atsmith3/IFE_DISPLAY_2017_18/Software/sprites/385_sprites/win_screen.bmp

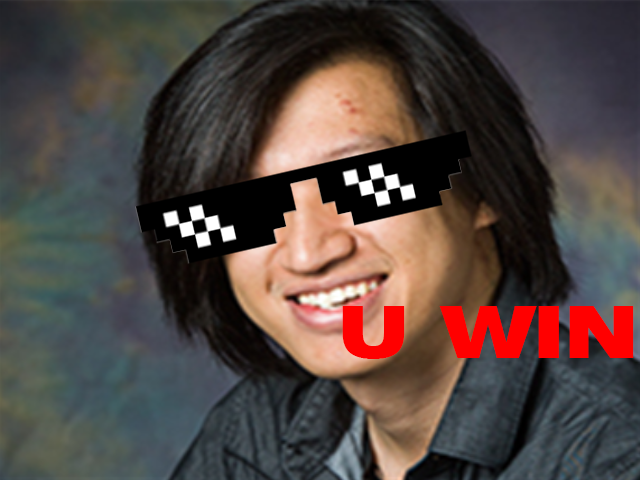
Software/sprites/385_sprites/win_screen.bmp
