atsmith3/IFE_DISPLAY_2017_18/Documentation/BreakoutBoard.JPG

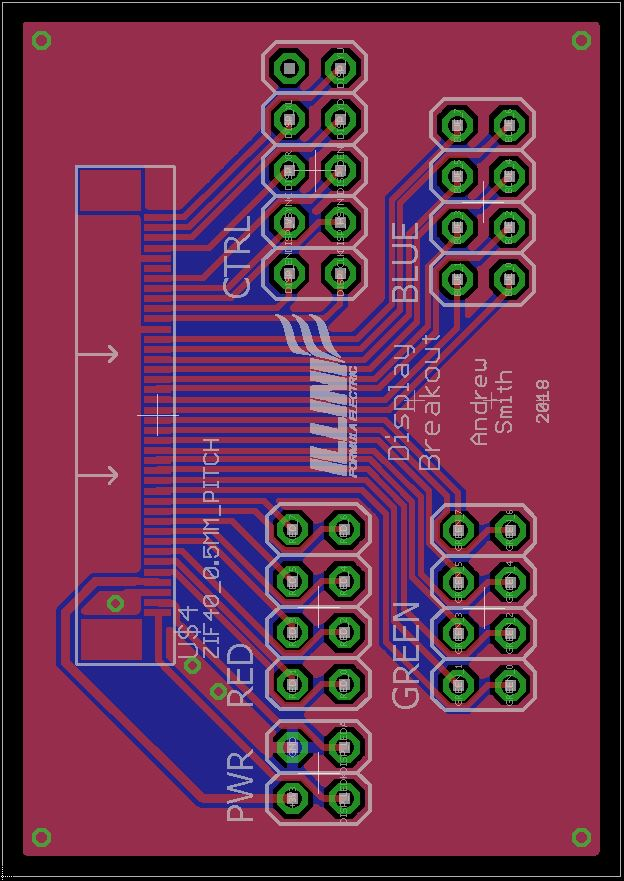
Documentation/BreakoutBoard.JPG
