atsmith3/IFE_DISPLAY_2017_18/Documentation/ife18_lowvoltage_display.pptx

## Display Driver Board

- Low Voltage

- Andrew Smith

## OVERVIEW

- This board will drive a 5.0 inch backlit TFT display to display useful information to the driver.
- Uses a FPGA to dive the display and a microcontroller to interface with the can network and control the sprites on screen.

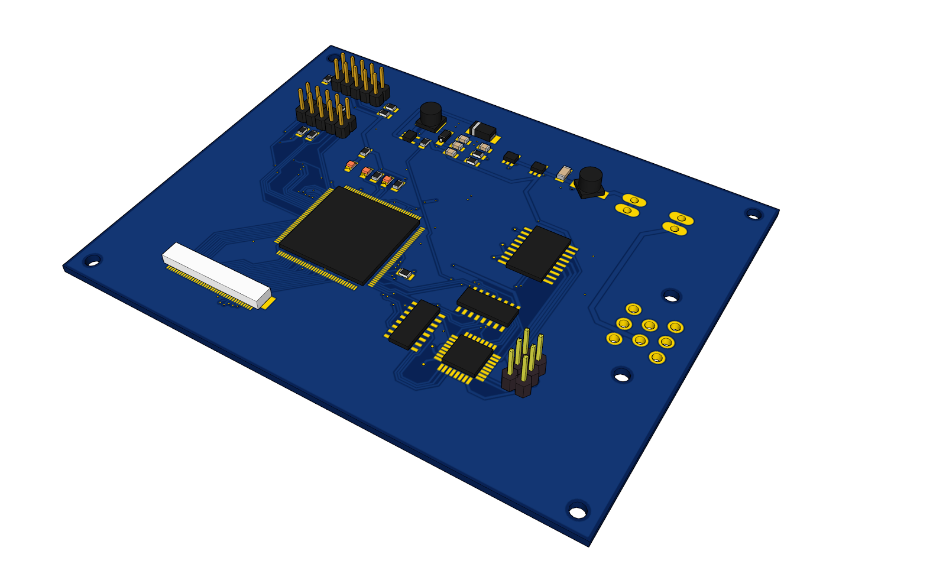
[picture p13: figure]

## Slide 3

- Final Design

## Power Supply

- Linear voltage regulators generate the 5V, 3.3V and 1.2V power levels.
- The FPGA also requires 1.2V supply for its logic elements which will be achieved with a 3.3V to 1.2V voltage regulator.
- Input filter to filter EMI from motor.

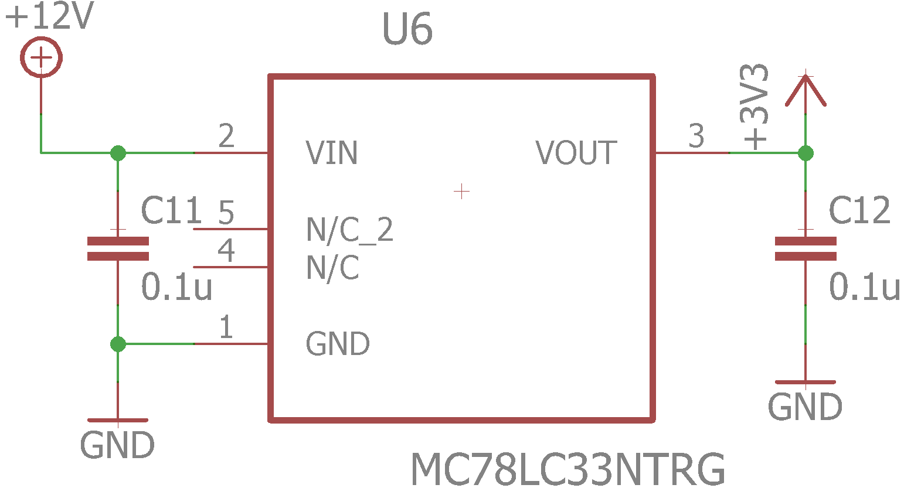
[picture p14: figure]
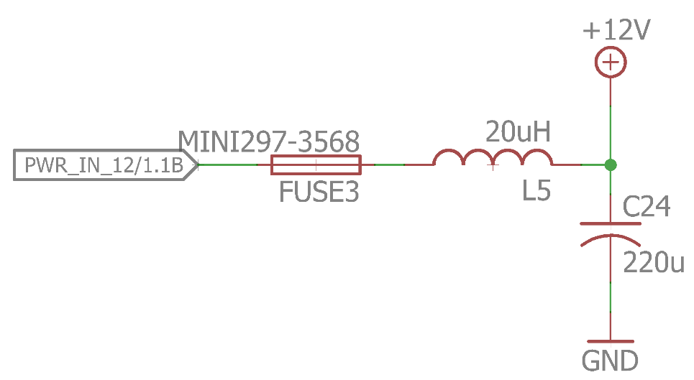
[picture p15: figure]

## Backlight

- Used a simple boost converter chip to boost the 5V supply to 24V to drive the LED backlight on the display.

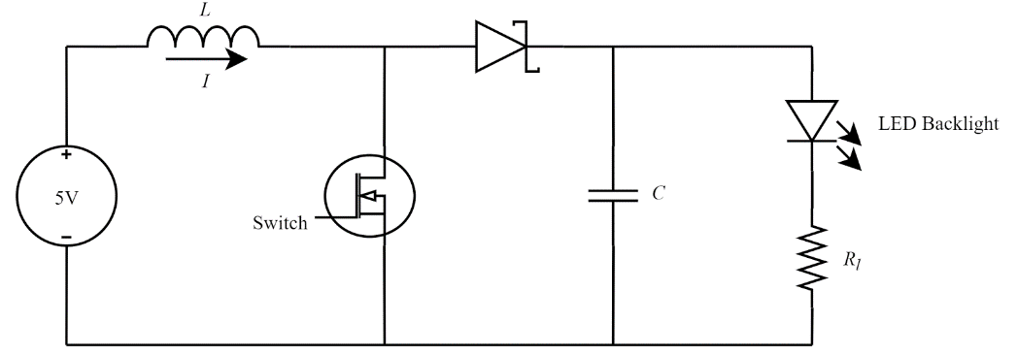
[picture p16: figure]
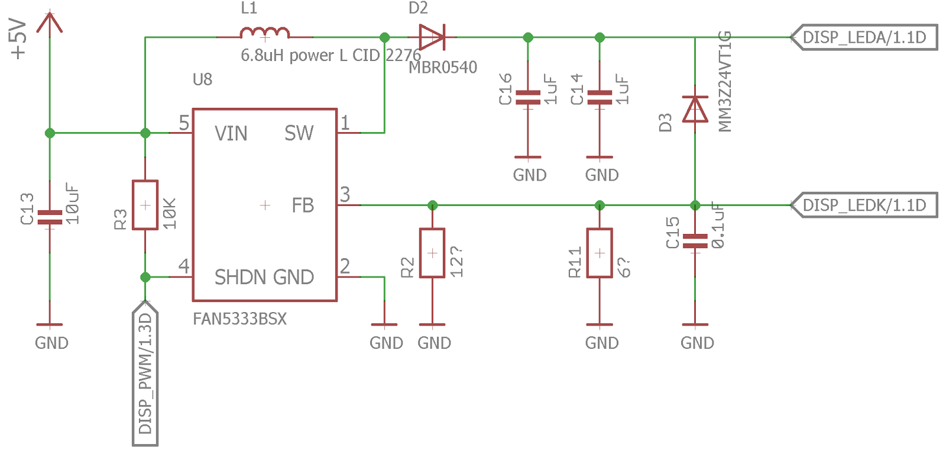
[picture p17: figure]

## FPGA

- I chose an FPGA to write to the display because I figured it would be easier to support custom graphics and be able to switch between different UI designs on the fly.
- The FPGA is a basic Cyclone II from Altera and it will boot off of a configuration flash.

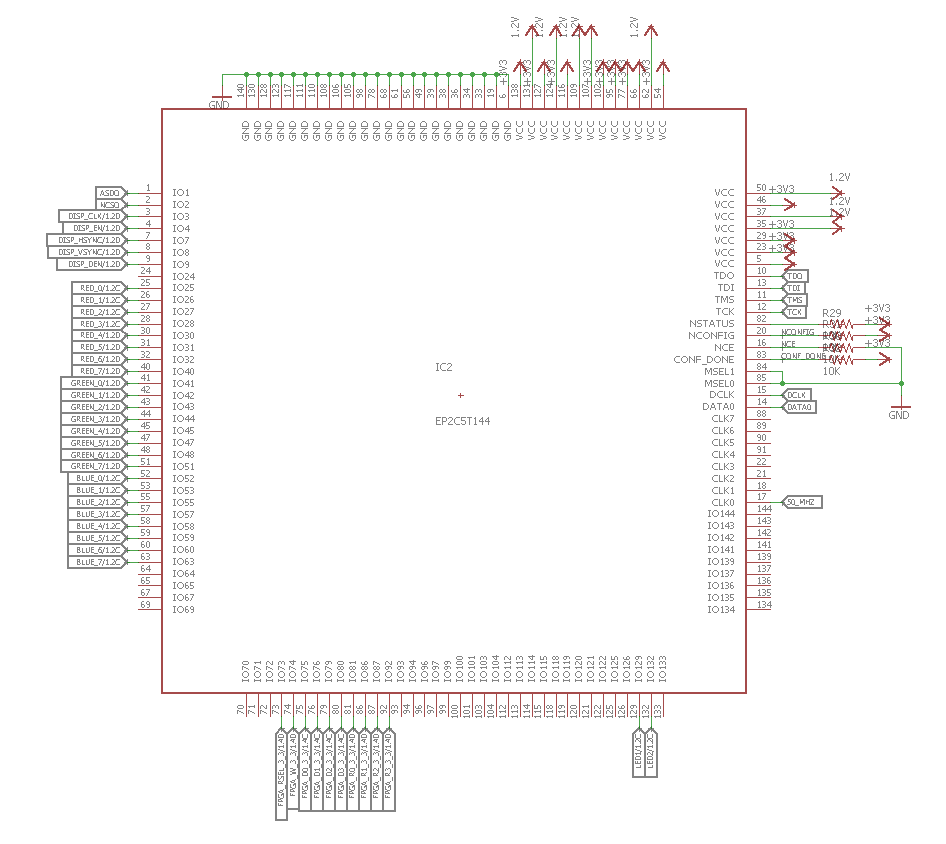
[picture p18: figure]
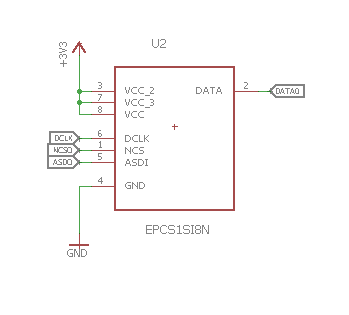
[picture p19: figure]

## Microcontroller and CAN

- I decided to go with an Atmega328P as the microcontroller because of its small footprint and its wide support in development tools.
- It will interface with the FPGA over a custom communication protocol modifying potentially 256 – byte registers.
- Standard SPI communications to the tested CAN Hardware.

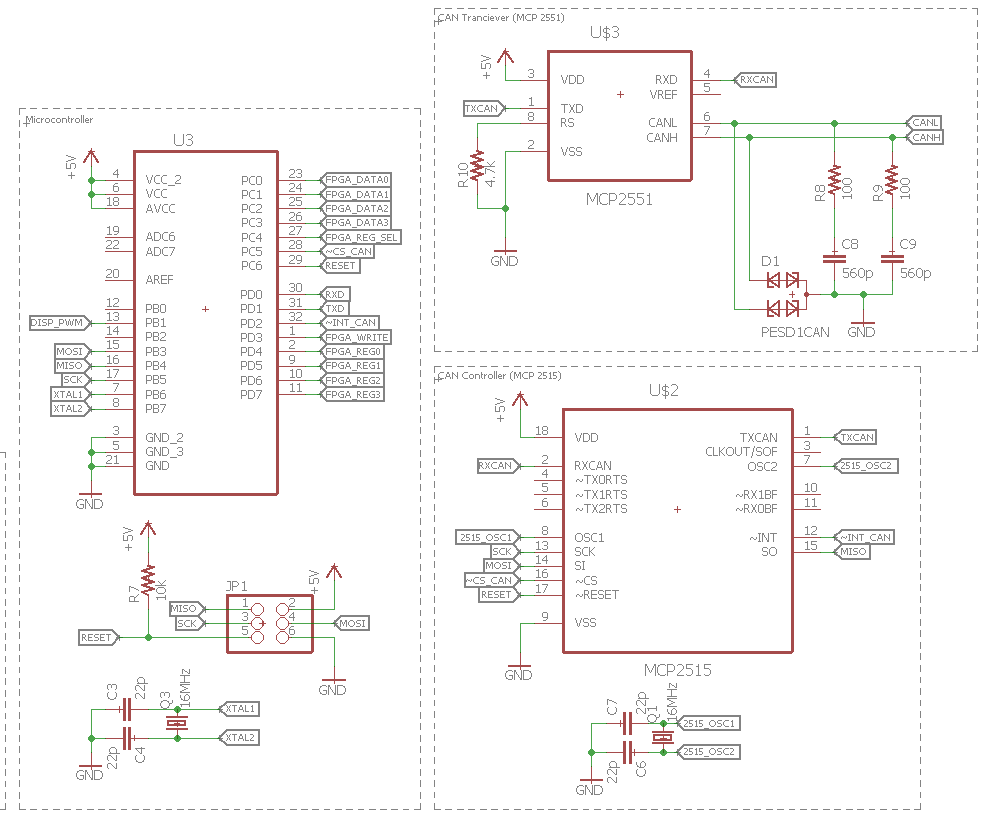
[picture p20: figure]

## PCB

- Current Hardware passes the ERC and the DRC tests on eagle for the Manufacturers 2 layer board specifications.

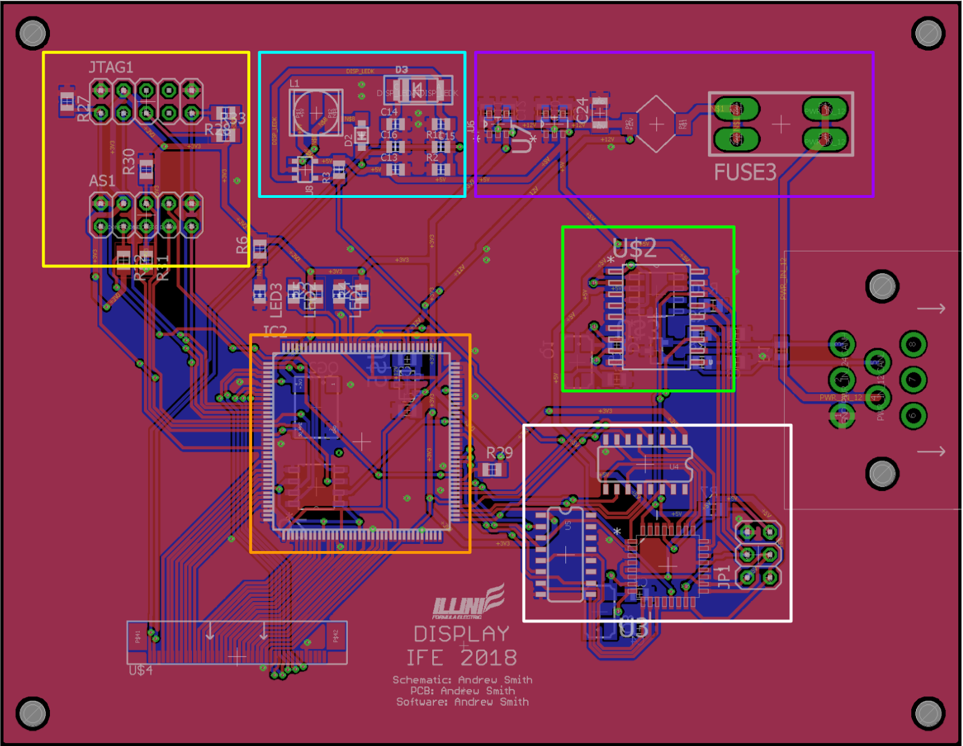
[picture p21: figure]

## Software

- Basic display modules written for the FPGA to display the IFE logo.
- Will build on top of this framework to support the GUI and graphics.
