atsmith3/IFE_DISPLAY_2017_18/Design/dash_horizontal.bmp

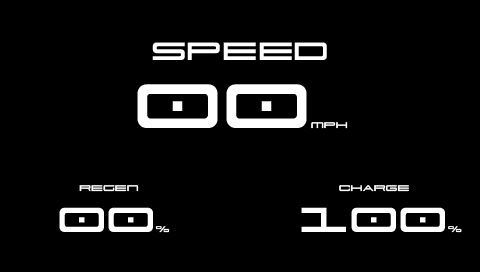
Design/dash_horizontal.bmp
