atsmith3/IFE_DISPLAY_2017_18/Design/dash_vertical.bmp

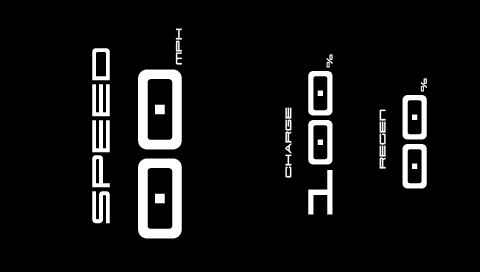
Design/dash_vertical.bmp
