atsmith3/IFE_DISPLAY_2017_18/Design/dash_vertical_blank.bmp

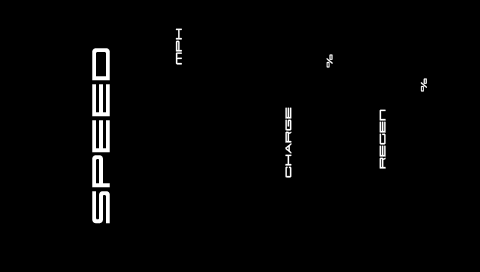
Design/dash_vertical_blank.bmp
