atsmith3/IFE_DISPLAY_2017_18/Design/disp.png

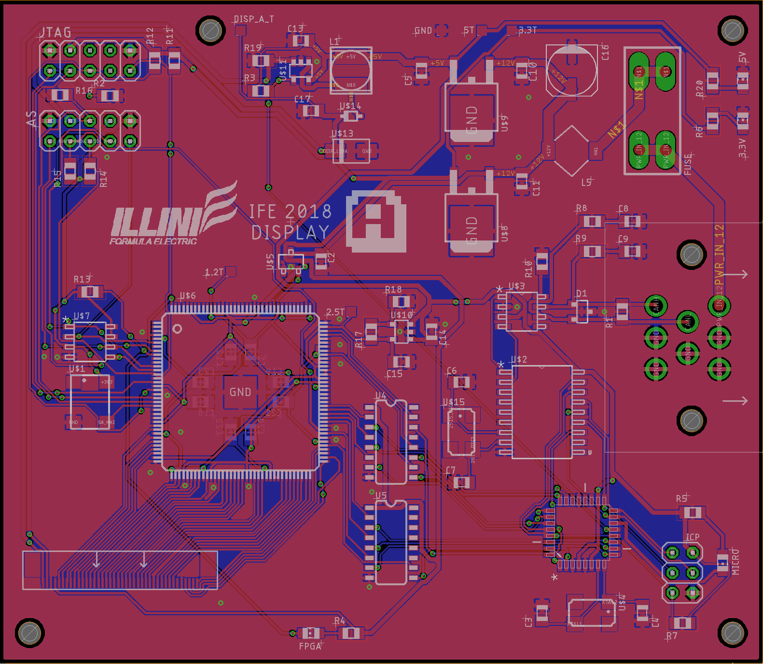
Design/disp.png
