atsmith3/IFE_DISPLAY_2017_18/Documentation/ucontroller_level_shifters.PNG

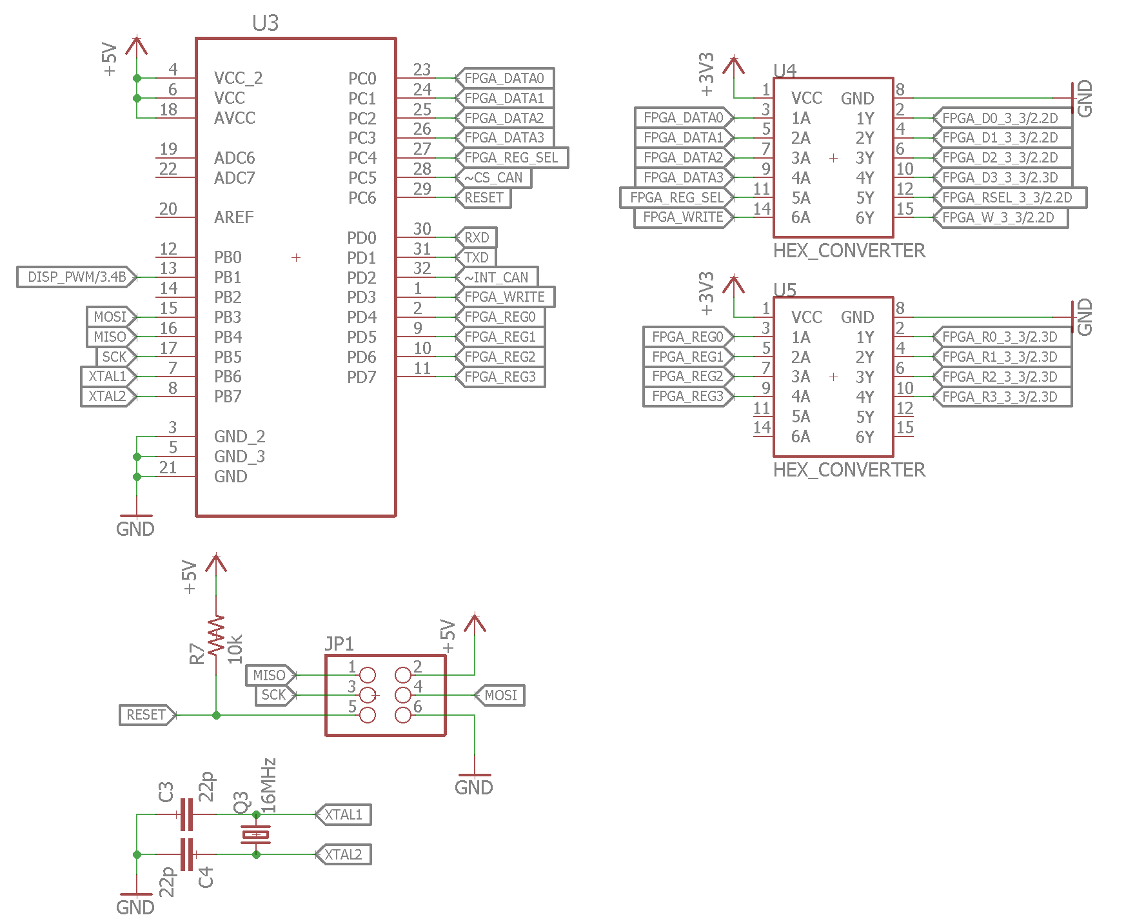
Documentation/ucontroller_level_shifters.PNG
