atsmith3/IFE_DISPLAY_2017_18/Documentation/v1_0_0_Dimensions.PNG

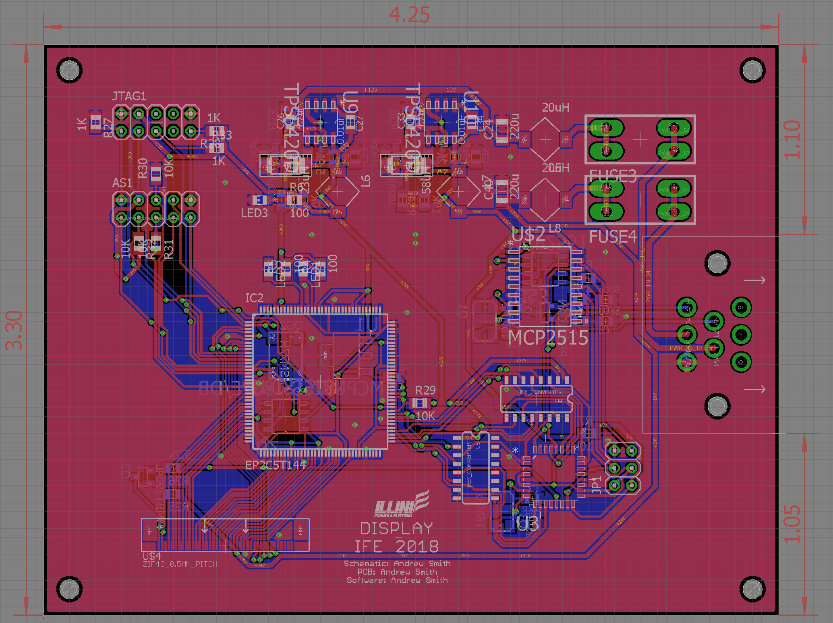
Documentation/v1_0_0_Dimensions.PNG
