atsmith3/IFE_DISPLAY_2017_18/Schematics/IFE_DISPLAY/eagleUp/eagleUp_Display_Board_board_top.jpg

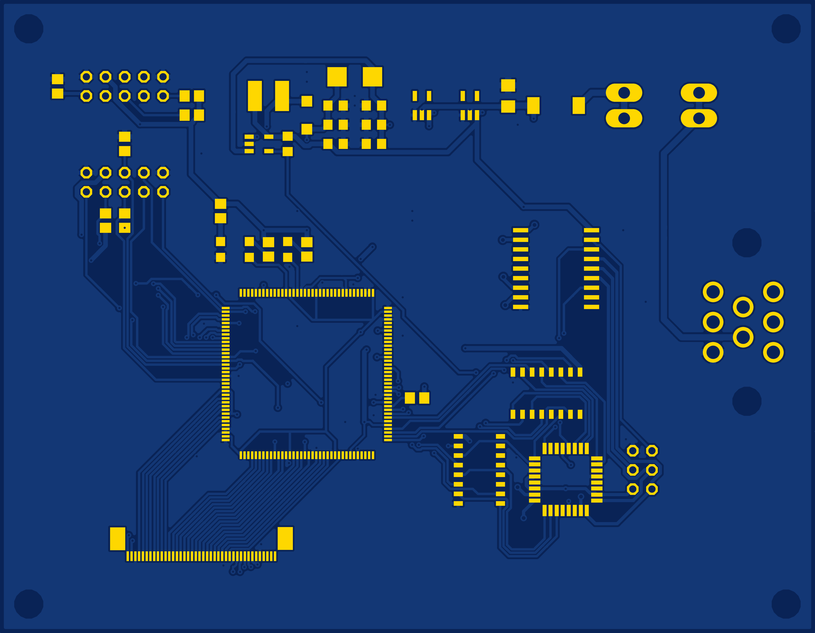
Schematics/IFE_DISPLAY/eagleUp/eagleUp_Display_Board_board_top.jpg
