atsmith3/IFE_DISPLAY_2017_18/Software/sprites/385_sprites/Background-PACMAN.bmp

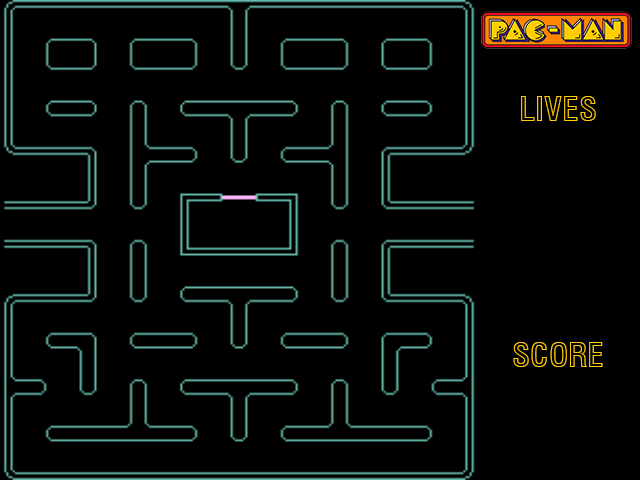
Software/sprites/385_sprites/Background-PACMAN.bmp
