atsmith3/IFE_DISPLAY_2017_18/Software/sprites/385_sprites/track_2_ghost.bmp

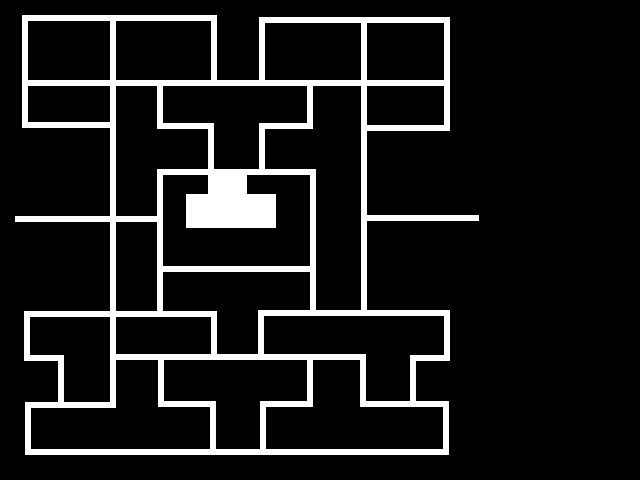
Software/sprites/385_sprites/track_2_ghost.bmp
