atsmith3/IFE_DISPLAY_2017_18/Software/sprites/packman_brd.bmp

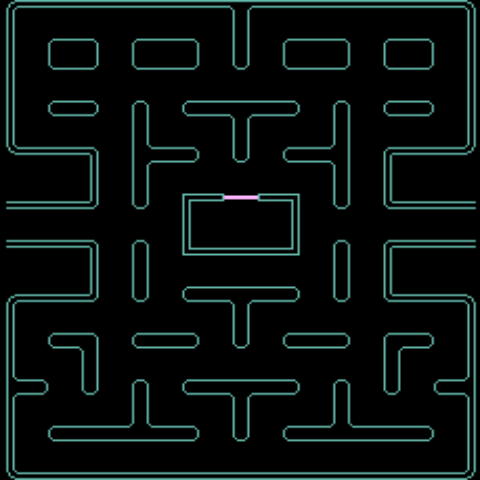
Software/sprites/packman_brd.bmp
