atsmith3/IFE_DISPLAY_2017_18/Components/Display_BOM.xlsx

IFE Display BOM 2017 - 2018
Item | Cost | Link
LCD 5 inch Display 480x272 TFT Module OPTL Touch Screen for MP4,GPS | $13.95 | http://www.buydisplay.com/default/lcd-5-inch-display-480x272-tft-module-touch-screen-for-mp4-gps
