atsmith3/IFE_DISPLAY_2017_18/Schematics/IFE_DISPLAY/bom.xlsx

Part | Value | Device | Package | Description | MPN | Quantity | Price | Link
R11 | 6 | RESISTOR_0805MP | _0805MP | Resistors |  | 1
R2 | 12 | RESISTOR_0805MP | _0805MP | Resistors |  | 1
AS1 |  | PINHD-2X5 | 2X05 | PIN HEADER |  | 1
JP1 |  | PINHD-2X3 | 2X03 | PIN HEADER |  | 1
JTAG1 |  | PINHD-2X5 | 2X05 | PIN HEADER |  | 1
LED1 |  | LEDCHIP-LED0805 | CHIP-LED0805 | LED |  | 3
U3 |  | ATMEGA328P-AU | QFP80P900X900X120-32N | 8-bit Microcontroller with In-System Programmable Flash | ATMEGA328P-AU | 1 | $2.18 | https://www.digikey.com/product-detail/en/microchip-technology/ATMEGA328P-AUR/ATMEGA328P-AURCT-ND/3789455
C5 | 0.1u | C-EUC0805K | C0805K | CAPACITOR, European symbol |  | 5
R4 | 100 | R-US_R0805 | R0805 | RESISTOR, American symbol |  | 5
R3 | 10K | RESISTOR_0805MP | _0805MP | Resistors |  | 6
C13 | 10uF | CAP_CERAMIC_0805MP | _0805MP | Ceramic Capacitors |  | 1
R1 | 120 | R-US_R0805 | R0805 | RESISTOR, American symbol |  | 1
Q1 | 16MHz | CRYSTALCTS406 | CTS406 | CRYSTAL |  | 2
R27 | 1K | R-US_R0805 | R0805 | RESISTOR, American symbol |  | 3
C1 | 1uF | C-EUC0805K | C0805K | CAPACITOR, European symbol |  | 4
L5 | 20uH | MSS7348 | MSS7348 | Inductors |  | 1
C24 | 220u | C1206 | C1206 |  |  | 1
C3 | 22p | C-EUC0805K | C0805K | CAPACITOR, European symbol |  | 4
R10 | 4.7k | R-US_R0805 | R0805 | RESISTOR, American symbol |  | 1
C8 | 560p | C-EUC0805K | C0805K | CAPACITOR, European symbol |  | 2
L1 | 6.8uH power L CID 2276 | INDUCTORNR5040 | INDUCTOR_5X5MM_NR5040_NOTHERMALS | Inductors |  | 1
U$1 | 776280-1 | 776280-1 | 776280-1 | AMPSEAL 8pin Connector |  | 1
IC2 | EP2C5T144 | EP2C5T144 | TQFP144 | EP2C5T144 | EP2C5T144C8N | 1 | $14.72 | https://www.digikey.com/product-detail/en/altera/EP2C5T144C8N/544-1665-ND/1084579
U2 | EPCS1SI8N | EPCS1SI8N | SOIC127P600X175-8N | Serial Configuration Devices | EPCS1SI8N | 1 | $4.27 | https://www.digikey.com/products/en?keywords=EPCS1SI8N
U8 | FAN5333BSX | FAN5331 | SOT23-5@1 | FAN5331 - LED/OLED 20V Boost Converter |  | 1 | $0.99 | https://www.digikey.com/product-detail/en/on-semiconductor/FAN5331SX/FAN5331SXCT-ND/820868
U4 | HEX_CONVERTER | HEX_CONVERTER | SO016 | 74HC4050 Hex Buffer Level Shifter SMD SO016 |  | 2 | $0.47 | https://www.digikey.com/product-detail/en/nexperia-usa-inc/74HC4050D653/1727-6331-1-ND/2762840
D2 | MBR0540 | DIODESOD-123 | SOD-123 | Diode |  | 1 | $0.41 | https://www.digikey.com/product-detail/en/micro-commercial-co/MBR0540-TP/MBR0540TPMSCT-ND/717367
U6 | MC78LC33NTRG | MC78LC33NTRG | SOT95P275X110-5N | Micropower Voltage Regulator | MC78LC33NTRG | 1 | $0.91 | https://www.digikey.com/product-detail/en/on-semiconductor/MC78LC33NTRG/MC78LC33NTRGOSCT-ND/1139753
U7 | MC78LC50NTRG | MC78LC50NTRG | SOT95P275X110-5N | Micropower Voltage Regulator | MC78LC50NTRG | 1 | $0.82 | https://www.digikey.com/product-detail/en/on-semiconductor/MC78LC50NTRG/MC78LC50NTRGOSCT-ND/1139754
U$5 | MCP1702T-1202E/CB | MCP1702T-1802E/CB | SOT95P300X145-3N | Low Quiescent Current LDO Regulator | MCP1702T-1802E/CB | 1 | $0.50 | https://www.digikey.com/product-detail/en/microchip-technology/MCP1702T-1202E-CB/MCP1702T-1202E-CBCT-ND/1979892
U$2 | MCP2515 | MCP2515-I/SO | SOIC127P1034X264-18N | CAN Controller | MCP2515-I/SO | 1 | $1.91 | https://www.digikey.com/product-detail/en/microchip-technology/MCP2515T-I-SO/MCP2515T-I-SOCT-ND/4307902
U$3 | MCP2551 | MCP2551-I/SN | SOIC127P600X175-8N | High-Speed CAN Transceiver | MCP2551-I/SN | 1 | $1.24 | https://www.digikey.com/product-detail/en/microchip-technology/MCP2551T-E-SN/MCP2551T-E-SNCT-ND/4307904
FUSE3 | MINI297-3568 | MINI297-3568 | 3568 |  |  | 1
D3 | MM3Z24VT1G | DIODESMA | SMADIODE | Diode |  | 1 | $0.30 | https://www.digikey.com/product-detail/en/on-semiconductor/SZMM3Z24VT1G/SZMM3Z24VT1GOSCT-ND/5969235
D1 | PESD1CAN | PESD1CAN | SOT23 | CAN bus ESD protection diode |  | 1 | $0.93 | https://www.digikey.com/product-detail/en/littelfuse-inc/SM712-02HTG/F6450CT-ND/5019610
QG2 | SM77H | SM77H | SM77H | 3.3V CMOS Clock Oscillator |  | 1 | $1.86 | https://www.digikey.com/product-detail/en/abracon-llc/ASCO-50.000MHZ-EK-T3/535-12076-1-ND/4092568
U$4 | ZIF40_0.5MM_PITCH | ZIF40_0.5MM_PITCH | ZIF40 | 40 Pin 0.5mm ptch FPC Connector |  | 1 | 0.9 | https://www.digikey.com/product-detail/en/amphenol-fci/62684-401100ALF/609-1195-1-ND/1003054
