atsmith3/IFE_DISPLAY_2017_18/(list of files, cad)

Other CAD files:
3-D Models/display.skp
Software/SYSTEM_VERILOG_DISPLAY/simulation/modelsim/rtl_work/display_controller/verilog.psm
Software/SYSTEM_VERILOG_DISPLAY/simulation/modelsim/rtl_work/display_tb/verilog.psm
Software/SYSTEM_VERILOG_DISPLAY/simulation/modelsim/rtl_work/top/verilog.psm
