atsmith3/IFE_DISPLAY_2017_18/Documentation/SAE-DES peer evaluations fa2017-AndrewSmith.xlsx

SAE/DES Peer Evaluations
Evaluator:
Class Rubric | Number | Student Name | Email | Cr. Hours | Letter Grade and Comments
ENG | 491SAE | Shreyas Dmello | sdmello2@illinois.edu | 3 | A ; Good work as a leader, helpful, always there to answer questions.
ENG | 491SAE | Andy Kopplin | ajkoppl2@illinois.edu | 3
ENG | 491SAE | Joseph Kraemer | jakraem2@illinois.edu | 3
ENG | 491SAE | Jenna Leane | jleane2@illinois.edu | 3
ENG | 491SAE | Dylan McGregor | dmcgreg2@illinois.edu | 3
ENG | 491SAE | Brittany Poppen | bpoppen2@illinois.edu | 3
ENG | 491SAE | Remington Reid | rsreid2@illinois.edu | 3
ENG | 491SAE | Mrunal Sarvaiya | sarvaiy2@illinois.edu | 3
ENG | 491SAE | James Schackmuth | schckmt2@illinois.edu | 3
ENG | 491SAE | Andrew Smith | atsmith3@illinois.edu | 3
ENG | 491SAE | Jesse Thoma | jthoma3@illinois.edu | 3 | A ; Good work as a leader, helpful, always there to answer questions, easy to work with an discuss new ideas.
ENG | 491SAE | Benjamin Williams | bjwllms2@illinois.edu | 3
ENG | 491SAE | Matthew Zalewski | mzalews2@illinois.edu | 3
ME | 199ADV | Jacob Leonard | jleonrd2@illinois.edu | 3
ME | 199ADV | Matthew Metzler | mpmetzl2@illinois.edu | 3 | A ; Good work as a leader. Very invested in the team and he makes sure that every one puts in their best effort. I have enjoyed working with Matt this semester.
ME | 199ADV | Alan Papalia | papalia2@illinois.edu | 3
ME | 199ADV | Michael Rogalski | mprogal2@illinois.edu | 3
ME | 199ADV | Brian Smith | bnsmith5@illinois.edu | 3
ME | 199ADV | Joshua Song | jssong3@illinois.edu | 3 | A ; Good work as a leader, he was organized and on top of his work this semester, helped out with the eagle design workshop.
ME | 199ADV | John Speckels | speckls2@illinois.edu | 3
ME | 199ADV | Amirardalan Tajbakhsh | atajba2@illinois.edu | 3
ME | 199ADV | Tanay Vardhan | tvardha2@illinois.edu | 3
ME | 199ADV | Junwu Zhang | jzhng120@illinois.edu | 3
ME | 199SAE | Adreet Agrawal | adreeta2@illinois.edu | 1
ME | 199SAE | Richard Alonso | ralonso3@illinois.edu | 1
ME | 199SAE | Faisal Alsayed | faa2@illinois.edu | 1
ME | 199SAE | Stefanie Anderson | sta4@illinois.edu | 1
ME | 199SAE | Spencer Andrews | sra4@illinois.edu | 1
ME | 199SAE | Edisson Arias | eparias2@illinois.edu | 1
ME | 199SAE | Christian Arreaza-Rosa | carrea2@illinois.edu | 1
ME | 199SAE | Ismael Arreola | ismaela2@illinois.edu | 1
ME | 199SAE | Nathan Asad | nasad3@illinois.edu | 1
ME | 199SAE | Ashwin Azhagiri | ashwina2@illinois.edu | 1
ME | 199SAE | Christopher Bauer | crbauer@illinois.edu | 1
ME | 199SAE | Jacob Berry | jacobb4@illinois.edu | 1
ME | 199SAE | Justin Bifeld | jbifeld2@illinois.edu | 1
ME | 199SAE | Spencer Binning | binning2@illinois.edu | 1
ME | 199SAE | Dean Biskup | dbiskup2@illinois.edu | 1
ME | 199SAE | Andrew Bocklund | andrewb2@illinois.edu | 1
ME | 199SAE | Eugene Boguslavsky | bgslvsk2@illinois.edu | 1
ME | 199SAE | Francis Bongiovanni | fgb2@illinois.edu | 1
ME | 199SAE | Eric Brecklin | ebreck2@illinois.edu | 1
ME | 199SAE | Megin Budacki | budacki2@illinois.edu | 1
ME | 199SAE | Daniel Bumpus | dbumpus2@illinois.edu | 1
ME | 199SAE | Jacob Butera | jbutera2@illinois.edu | 1
ME | 199SAE | Matthew Carr | mtcarr2@illinois.edu | 1
ME | 199SAE | Blake Cedergren | blakerc2@illinois.edu | 1
ME | 199SAE | Albert Chan | albertc2@illinois.edu | 1
ME | 199SAE | Dylan Charter | dcharte2@illinois.edu | 1
ME | 199SAE | Qianzhong Chen | qc6@illinois.edu | 1
ME | 199SAE | Zongnan Chen | zongnan2@illinois.edu | 1
ME | 199SAE | Christopher Chong | cjchong2@illinois.edu | 1
ME | 199SAE | Rafael Cicogna Santos | rafaelc2@illinois.edu | 1
ME | 199SAE | Cristian Claramunt | claramu2@illinois.edu | 1
ME | 199SAE | Andrew Dai | adai20@illinois.edu | 1
ME | 199SAE | Brian Dardon | bdardon2@illinois.edu | 1
ME | 199SAE | Timothy Deckard | deckard2@illinois.edu | 1
ME | 199SAE | Dev Desai | devgd2@illinois.edu | 1
ME | 199SAE | Shail Desai | shailvd2@illinois.edu | 1
ME | 199SAE | Tyler Ditman | tcditma2@illinois.edu | 1
ME | 199SAE | Sean Dulkoski | seankd2@illinois.edu | 1
ME | 199SAE | Oscar Fatyga | ofatyga2@illinois.edu | 1
ME | 199SAE | Jorge Fernandez | jorgef2@illinois.edu | 1
ME | 199SAE | Martin Figueroa | mfigue28@illinois.edu | 1
ME | 199SAE | Keira Frese | frese2@illinois.edu | 1
ME | 199SAE | David Gable | dagable2@illinois.edu | 1
ME | 199SAE | John Goeckner | johnag2@illinois.edu | 1
ME | 199SAE | Yuliang Gu | yuliang3@illinois.edu | 1
ME | 199SAE | Nellie Haug | nhaug2@illinois.edu | 1
ME | 199SAE | Kevin Hernandez | kherna28@illinois.edu | 1
ME | 199SAE | Veronica Holloway | veh2@illinois.edu | 1
ME | 199SAE | Paul Incapreo | paulei2@illinois.edu | 1
ME | 199SAE | Kyle Kallberg | klk2@illinois.edu | 1
ME | 199SAE | Rebecca Kasner | rkasner2@illinois.edu | 1
ME | 199SAE | Praveen Kattappurath | pgk2@illinois.edu | 1
ME | 199SAE | William Keaty | wkeaty2@illinois.edu | 1
ME | 199SAE | Sean Kenny | spkenny2@illinois.edu | 1
ME | 199SAE | Guyoung Kim | guyoung2@illinois.edu | 1
ME | 199SAE | Timothy Kogucki | kogucki2@illinois.edu | 1
ME | 199SAE | Aleksandar Konstantinovic | ak15@illinois.edu | 1
ME | 199SAE | David Kordaczka | davidk4@illinois.edu | 1
ME | 199SAE | Joseph Koszut | jkoszut2@illinois.edu | 1
ME | 199SAE | Harikrishnan Kumar | hk6@illinois.edu | 1
ME | 199SAE | Byunghoon Kwon | bk7@illinois.edu | 1
ME | 199SAE | Adrian Lach | alach5@illinois.edu | 1
ME | 199SAE | Gustau Lundegaard Lange | glange2@illinois.edu | 1
ME | 199SAE | Kang Joon Lee | kjl3@illinois.edu | 1
ME | 199SAE | Zhen Hong Leong | zhleong2@illinois.edu | 1
ME | 199SAE | Ian Li | ianli2@illinois.edu | 1
ME | 199SAE | Ruiheng Liu | rrliu3@illinois.edu | 1
ME | 199SAE | Yinshuo Liu | yinshuo2@illinois.edu | 1
ME | 199SAE | Mario Lopez Graciano | mlopez87@illinois.edu | 1
ME | 199SAE | Endy Lozano | elozan4@illinois.edu | 1
ME | 199SAE | Haotian Lu | haotian8@illinois.edu | 1
ME | 199SAE | William Ma | wma21@illinois.edu | 1
ME | 199SAE | Jack Mahoney | jsmahon2@illinois.edu | 1
ME | 199SAE | Vaibhav Makar | vmakar2@illinois.edu | 1
ME | 199SAE | Joseph Maloney | jpmalon2@illinois.edu | 1
ME | 199SAE | Rishi Masand | rmasand2@illinois.edu | 1
ME | 199SAE | Donald Mascio | dmasci2@illinois.edu | 1
ME | 199SAE | Michael McInerney | mm26@illinois.edu | 1
ME | 199SAE | Graham McLagan | gmclaga2@illinois.edu | 1
ME | 199SAE | Sean McShane | sjm2@illinois.edu | 1
ME | 199SAE | Kayleigh Meinzen | meinzen2@illinois.edu | 1 | A ; I have worked with Kayleigh this semester discussing design of LV boards and the boxes. She is very easy to work with and we had a good discussion about what kind of connectors to use to make her life easier as well as how we want to mount the boards inside of the boxes.
ME | 199SAE | Mason Metzkes | metzkes2@illinois.edu | 1
ME | 199SAE | Erik Meyer | erikm2@illinois.edu | 1
ME | 199SAE | Jacob Miller | jacobwm2@illinois.edu | 1
ME | 199SAE | Mugdha Mittal | mugdham2@illinois.edu | 1
ME | 199SAE | Miranda Moody | mamoody2@illinois.edu | 1
ME | 199SAE | Kyle Moreau | moreau2@illinois.edu | 1
ME | 199SAE | Javier Mulero | jmulero2@illinois.edu | 1
ME | 199SAE | Kevin Murphy | kfmurph2@illinois.edu | 1
ME | 199SAE | Elaine Nielsen | elainen2@illinois.edu | 1
ME | 199SAE | Nicholas O'Brien | nobrien3@illinois.edu | 1
ME | 199SAE | Jonathan Ortiz | jortiz63@illinois.edu | 1
ME | 199SAE | Hannah Park | hrpark2@illinois.edu | 1
ME | 199SAE | Colin Peddycoart | pddycrt2@illinois.edu | 1
ME | 199SAE | Elise Perry | elise2@illinois.edu | 1
ME | 199SAE | Milos Popovic | milosp2@illinois.edu | 1
ME | 199SAE | Jacob Povlich | povlich2@illinois.edu | 1
ME | 199SAE | Salaam Qatanani | ssq2@illinois.edu | 1
ME | 199SAE | Ruoyang Qu | rqu3@illinois.edu | 1
ME | 199SAE | Mohamed Radwan | mradwa4@illinois.edu | 1
ME | 199SAE | Lyle Regenwetter | regnwttr@illinois.edu | 1
ME | 199SAE | Daniel Rhyoo | drhyoo2@illinois.edu | 1 | A ; I have never worked directly with daniel but he is one of the best guys on the team. His effort and quality of work that he puts in is off the charts. He is also very friendly and always around to answer my questions.
ME | 199SAE | David Richardson | drr2@illinois.edu | 1
ME | 199SAE | Joshua Rosenthal | jtr3@illinois.edu | 1
ME | 199SAE | Nathan Ruxlow | nruxlow2@illinois.edu | 1
ME | 199SAE | Collin Schmidt | collin3@illinois.edu | 1
ME | 199SAE | Daniel Schmitt | daschmi2@illinois.edu | 1
ME | 199SAE | Etai Schnitman | etais2@illinois.edu | 1
ME | 199SAE | Courtney Seckman | seckman2@illinois.edu | 1
ME | 199SAE | Salvador Sepulveda | ss10@illinois.edu | 1
ME | 199SAE | Birdal Serbest | birdals2@illinois.edu | 1
ME | 199SAE | Abhinav Singh | abhinav6@illinois.edu | 1
ME | 199SAE | Ryan Siu | ryansiu3@illinois.edu | 1
ME | 199SAE | Marcin Sobas | msobas2@illinois.edu | 1
ME | 199SAE | Sai-Aksharah Sriraman | sssrira2@illinois.edu | 1
ME | 199SAE | Kyle Stearns | kylems2@illinois.edu | 1
ME | 199SAE | Henry Steenkolk | steenko2@illinois.edu | 1 | A ; I never worked directly with henry but he is organized and ontop of his aero projects this year.
ME | 199SAE | Spencer Sullivan-Hayes | sjs7@illinois.edu | 1
ME | 199SAE | Willem Trenkenschu | trenken2@illinois.edu | 1
ME | 199SAE | Nicholas Tuczak | njtucza2@illinois.edu | 1 | A ; a great Co-Leader for the Display Electronics. Comes to every D.E. meeting and is always prepared to answer questions. Has helped me lead the eagle workshops as well as the Display Electronics design meetings. He is also very interested in continuing to learn and develop his skills in layout and design.
ME | 199SAE | Joseph Uhrich | uhrich2@illinois.edu | 1
ME | 199SAE | Ethan Uken | enuken2@illinois.edu | 1
ME | 199SAE | Eldar Uzicanin | euzica2@illinois.edu | 1
ME | 199SAE | Rafael Velazquez | rafaelv3@illinois.edu | 1
ME | 199SAE | Dirk Wallace | dirkcw2@illinois.edu | 1
ME | 199SAE | Christian Williams | cwill35@illinois.edu | 1
ME | 199SAE | Alexander Witek | amwitek2@illinois.edu | 1 | A ; Good work leading the business team. Punctual and organized.
ME | 199SAE | Joshua Wrobel | jiw2@illinois.edu | 1
ME | 199SAE | Renhao Wu | renhaow2@illinois.edu | 1
ME | 199SAE | Jingwei Xu | jingwei8@illinois.edu | 1
ME | 199SAE | Joseph Zabinski | jzabins2@illinois.edu | 1
ME | 199SAE | Matthew Zhang | mgzhang2@illinois.edu | 1 | A ; I worked with matt for the design of the new steeringwheel. He is a smart individual and he was organized and on top of his project this year. He worked well discussing design ideas with me as well as the steering wheel eleectronics team.
ME | 199SAE | Chenyi Zhu | chenyi2@illinois.edu | 1
ME | 199SAE | Haoyang Zou | hz4@illinois.edu | 1
ME | 199DES | Joseph Byrnes | jabyrns2@illinois.edu | 1
ME | 199DES | Kyle Calvert | kylejc2@illinois.edu | 1
ME | 199DES | Rygar Carvajal | rygarc2@illinois.edu | 1
ME | 199DES | Antonino Cirrincione | ac22@illinois.edu | 1
ME | 199DES | Bailey Costello | baileyc2@illinois.edu | 1
ME | 199DES | Dawn Cronin | dncroni2@illinois.edu | 1
ME | 199DES | William Doherty | wjd2@illinois.edu | 1
ME | 199DES | Amalia Dungey | adungey2@illinois.edu | 1
ME | 199DES | John Eimerman | johne2@illinois.edu | 1
ME | 199DES | Henry Feldhaus | henryf2@illinois.edu | 1
ME | 199DES | Mark Galant | mgalant2@illinois.edu | 1
ME | 199DES | Yulin He | yulinh2@illinois.edu | 1
ME | 199DES | Zachary Hoegberg | zh2@illinois.edu | 1
ME | 199DES | Joseph Hong | jbh2@illinois.edu | 1
ME | 199DES | Nicholas Jew | njew2@illinois.edu | 1
ME | 199DES | Naman Jindal | namanj2@illinois.edu | 1
ME | 199DES | Rena Kanegae | kanegae2@illinois.edu | 1
ME | 199DES | Joel Khristy | khristy2@illinois.edu | 1
ME | 199DES | Tyler Kimmle | tkimmle2@illinois.edu | 1
ME | 199DES | Aman Kishore | amank2@illinois.edu | 1
ME | 199DES | Daniel Kofman | dkofman2@illinois.edu | 1
ME | 199DES | Genevieve Korn | gkorn2@illinois.edu | 1
ME | 199DES | Andrew Larkey | alarkey2@illinois.edu | 1
ME | 199DES | Peter Leung | peterhl2@illinois.edu | 1
ME | 199DES | Patric Liu | pfliu2@illinois.edu | 1
ME | 199DES | Adrian Manjarrez | adrianm3@illinois.edu | 1
ME | 199DES | Dhruv Mathur | dmathur2@illinois.edu | 1
ME | 199DES | Richard Mauge | mauge2@illinois.edu | 1
ME | 199DES | Nikhil Mehta | nikhilm3@illinois.edu | 1
ME | 199DES | Jonathan Mullen | jtmulle2@illinois.edu | 1
ME | 199DES | Mukhil Murugasamy | mukhilm2@illinois.edu | 1
ME | 199DES | Avani Patel | aap2@illinois.edu | 1
ME | 199DES | Kevin Peralta | kperal5@illinois.edu | 1
ME | 199DES | Caitlyn Peters | crp4@illinois.edu | 1
ME | 199DES | Thomas Phelps | tdphelp2@illinois.edu | 1
ME | 199DES | Amartya Purushottam | purusho2@illinois.edu | 1
ME | 199DES | Colton Rainey | crainey2@illinois.edu | 1
ME | 199DES | Jose Rafael Ridao | jridao2@illinois.edu | 1
ME | 199DES | Gulai Shen | gshen5@illinois.edu | 1
ME | 199DES | Tor Shepherd | tshephe2@illinois.edu | 1
ME | 199DES | Ann Thomas | ahthoma2@illinois.edu | 1
ME | 199DES | Isha Tyle | ityle2@illinois.edu | 1
ME | 199DES | Ingrida Valaitis | ivalai2@illinois.edu | 1
ME | 199DES | Robert Weiner | rtweine2@illinois.edu | 1
ME | 199DES | Oscar Wong | owwong2@illinois.edu | 1
ME | 199DES | James Wyeth | jamesw2@illinois.edu | 1
ME | 199DES | Haoze Yang | haozey2@illinois.edu | 1
