atsmith3/IFE_DISPLAY_2017_18/Eagle_Libs/Display_Custom.pdf

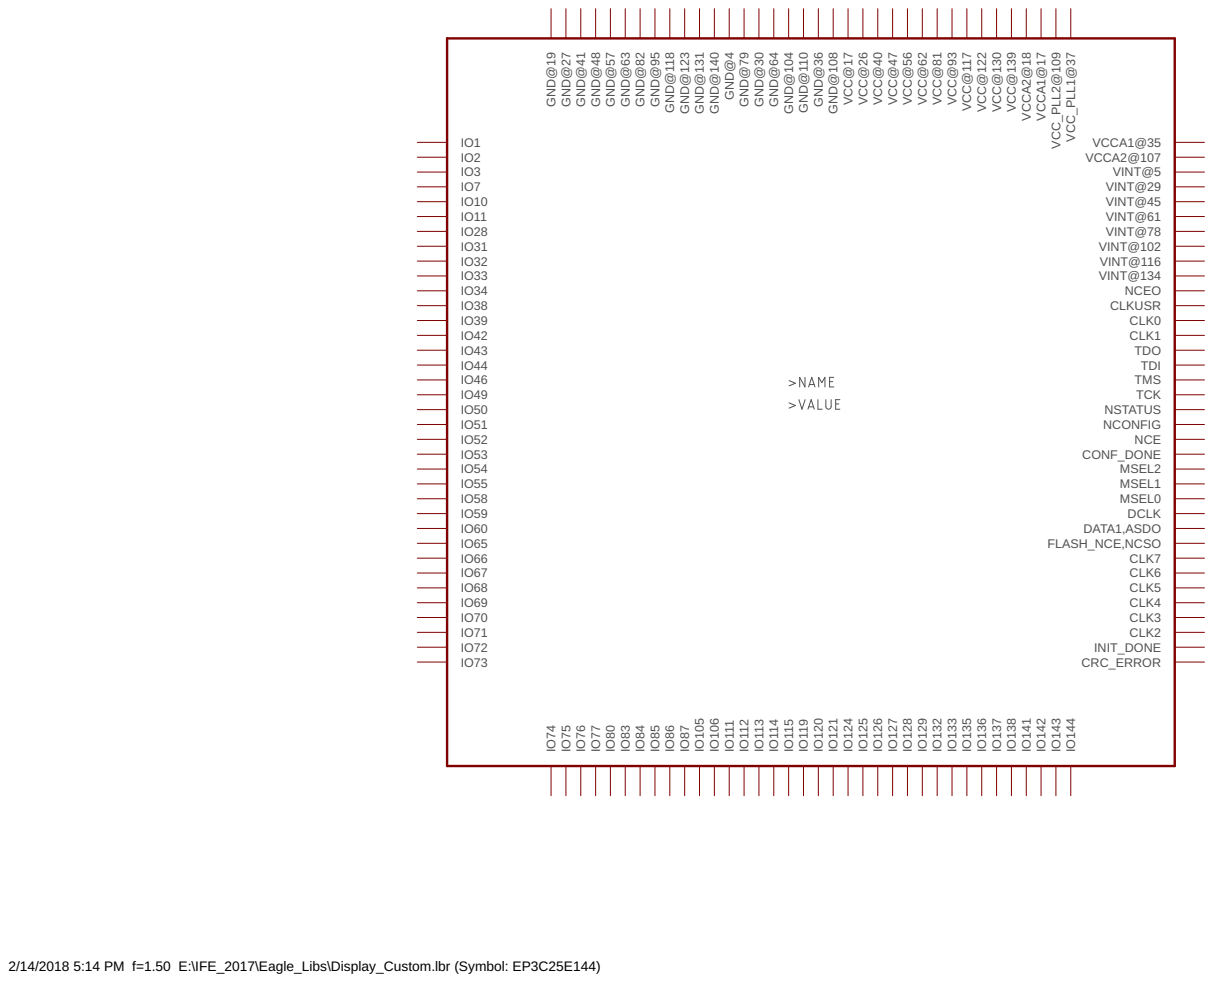
[picture p50: page 1]
