atsmith3/IFE_DISPLAY_2017_18/Schematics/IFE_DISPLAY/Display_Board_v4.brd

## EAGLE design Schematics/IFE_DISPLAY/Display_Board_v4.brd (2018-07-30)

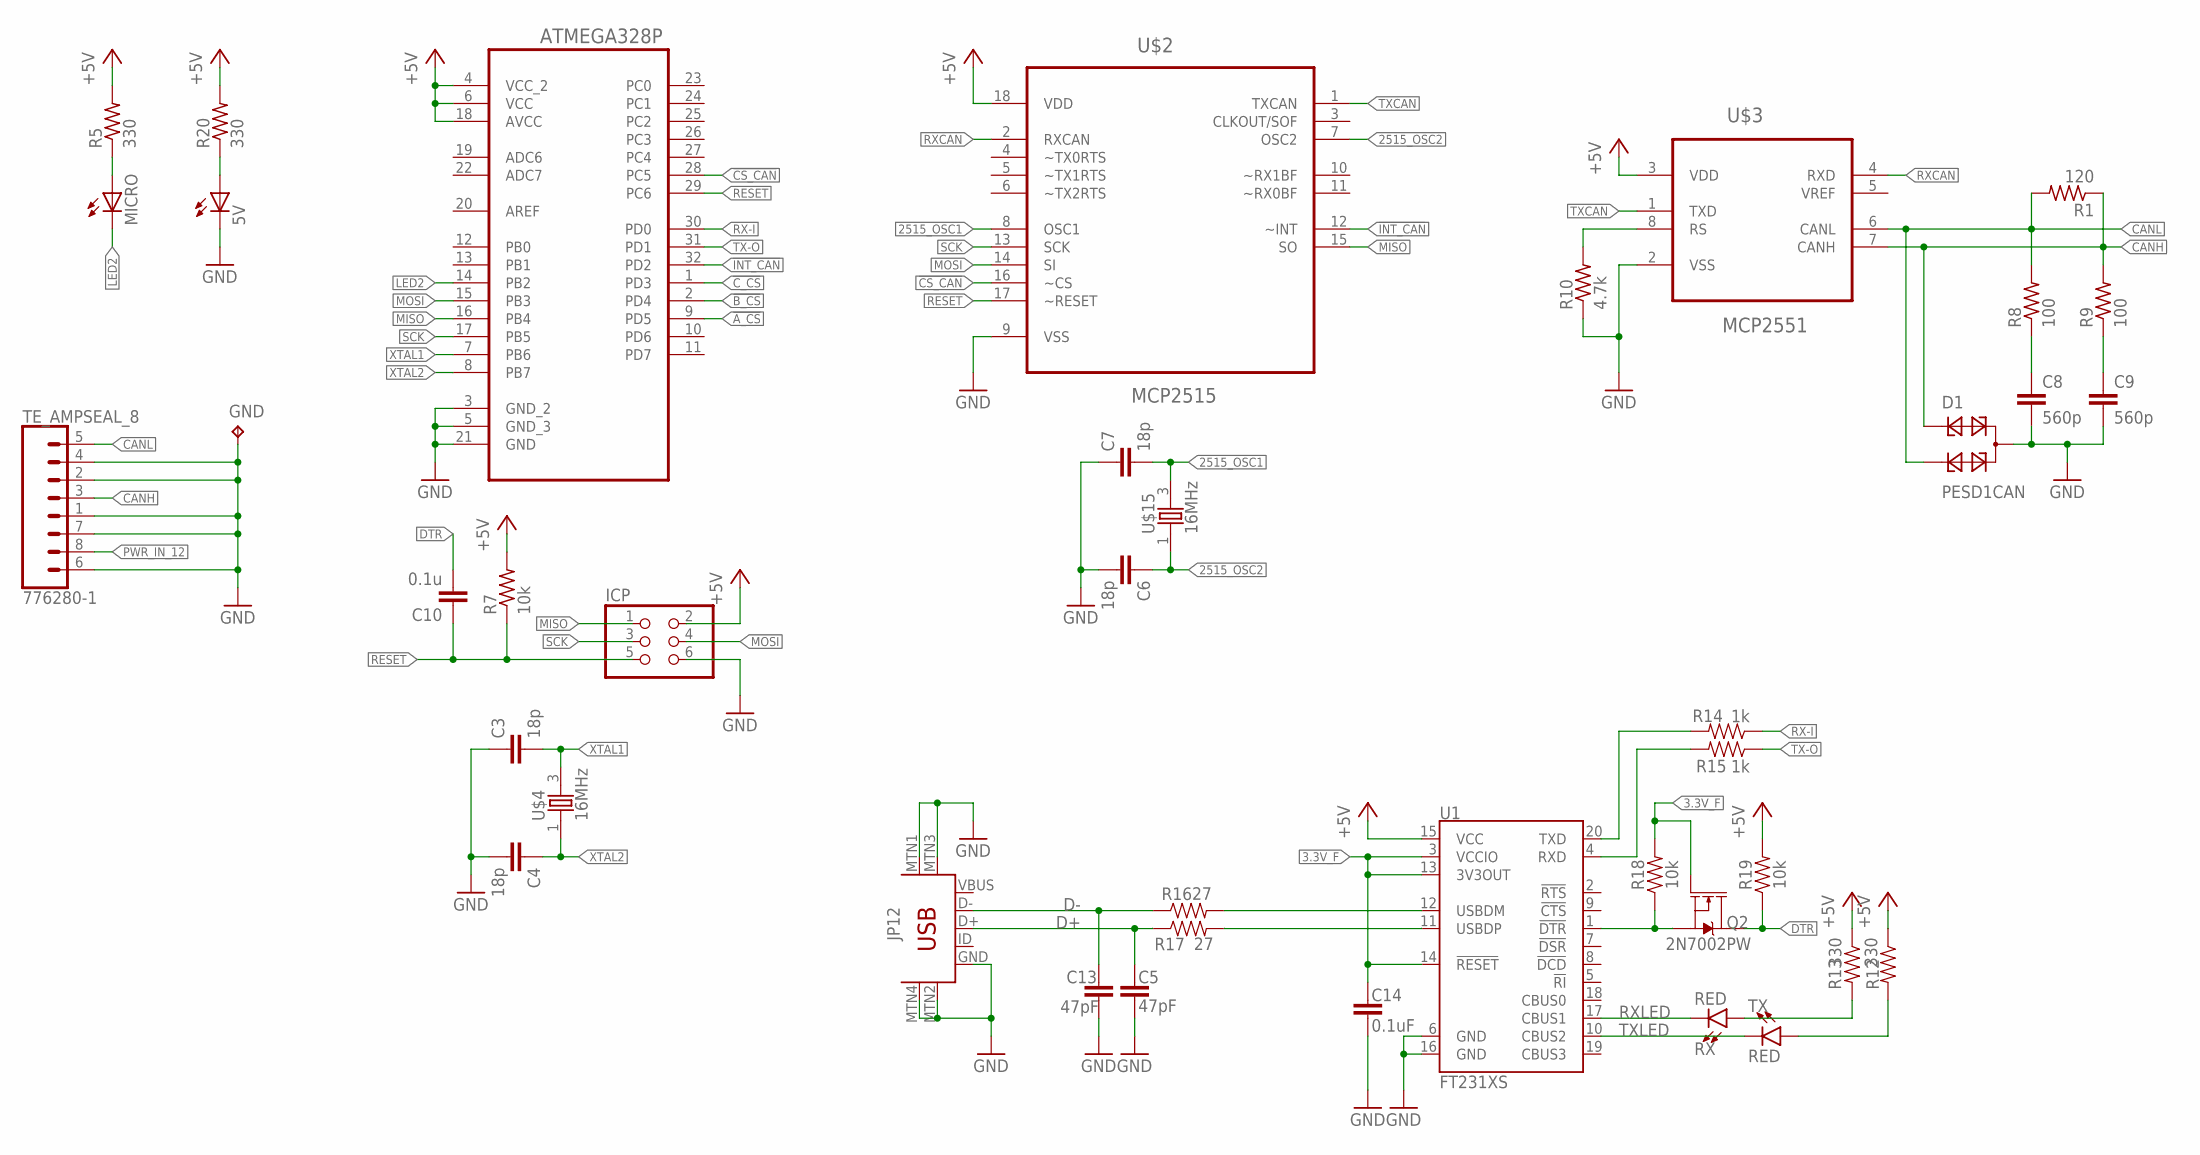
[picture p51: schematic Display_Board_v4.sch, sheet 1, <h3>Micro and CAN</h3>]

Parts:
5V: LEDCHIP-LED0805; CHIP-LED0805
ATMEGA328P: ATMEGA328P-AU; QFP80P900X900X120-32N
C3, C4, C6, C7: 18p; C0805K
C5, C13: 47pF; 0603
C8, C9: 560p; C0805K
C10: 0.1u; C0805K
C14: 0.1uF; 0603
D1: PESD1CAN; SOT23
GND: TPTP12SQ; TP12SQ
ICP: PINHD-2X3; 2X03
JP12: USB-MINIB-5PIN; USB-MINIB
MICRO: LEDCHIP-LED0805; CHIP-LED0805
Q2: 2N7002PW; SOT323
R1: 120; R0805
R5, R20: 330; R0805
R7: 10k; R0805
R8, R9: 100; R0805
R10: 4.7k; R0805
R12, R13: 330; 0603
R14, R15: 1k; 0603
R16, R17: 27; 0603
R18, R19: 10k; 0603
RX: RED; LED-1206
TE_AMPSEAL_8: 776280-1
TX: RED; LED-1206
U1: FT231XS; SSOP20_L
U$2: MCP2515; SOIC127P1034X264-18N
U$3: MCP2551; SOIC127P600X175-8N
U$4, U$15: 16MHz; CTS406

Connections:
3.3V_F: C14.1, Q2.1 (G), R18.2, U1.3 (VCCIO), U1.13 (3V3OUT), U1.14 (!RESET)
2515_OSC1: C7.2, U$2.8 (OSC1), U$15.3 (2)
2515_OSC2: C6.1, U$2.7 (OSC2), U$15.1
!A_CS: ATMEGA328P.9 (PD5); also elsewhere on the board
!B_CS: ATMEGA328P.2 (PD4); also elsewhere on the board
!CS_CAN: ATMEGA328P.28 (PC5), U$2.16 (~CS)
!C_CS: ATMEGA328P.1 (PD3); also elsewhere on the board
!INT_CAN: ATMEGA328P.32 (PD2), U$2.12 (~INT)
+5V: ATMEGA328P.4 (VCC_2), ATMEGA328P.6 (VCC), ATMEGA328P.18 (AVCC), ICP.2, R5.2, R7.2, R12.1, R13.1, R19.2, R20.2, U1.15 (VCC), U$2.18 (VDD), U$3.3 (VDD); also elsewhere on the board
CANH: D1.1, R1.1, R9.2, TE_AMPSEAL_8.3 (5), U$3.7 (CANH)
CANL: D1.2, R1.2, R8.2, TE_AMPSEAL_8.5 (8), U$3.6 (CANL)
D+: C5.1, JP12.D+, R17.1
D-: C13.1, JP12.D-, R16.1
DTR: C10.2, Q2.3 (D), R19.1
FTDI_DTR: Q2.2 (S), R18.1, U1.1 (!DTR)
GND: 5V.C, ATMEGA328P.3 (GND_2), ATMEGA328P.5 (GND_3), ATMEGA328P.21 (GND), C3.1, C4.2, C5.2, C6.2, C7.1, C8.2, C9.2, C13.2, C14.2, D1.3, GND.TP, ICP.6, JP12.GND, JP12.MTN1 (MTN2), JP12.MTN2 (MTN3), JP12.MTN3 (MTN1), JP12.MTN4, R10.1, TE_AMPSEAL_8.1 (4), TE_AMPSEAL_8.2 (6), TE_AMPSEAL_8.4 (7), TE_AMPSEAL_8.6 (1), TE_AMPSEAL_8.7 (3), U1.6 (GND), U1.16 (GND), U$2.9 (VSS), U$3.2 (VSS); also elsewhere on the board
LED2: ATMEGA328P.14 (PB2), MICRO.C
MISO: ATMEGA328P.16 (PB4), ICP.1, U$2.15 (SO); also elsewhere on the board
MOSI: ATMEGA328P.15 (PB3), ICP.4, U$2.14 (SI); also elsewhere on the board
unnamed: R12.2, TX.A
unnamed: R16.2, U1.12 (USBDM)
unnamed: MICRO.A, R5.1
unnamed: R17.2, U1.11 (USBDP)
unnamed: R10.2, U$3.8 (RS)
unnamed: C8.1, R8.1
unnamed: C9.1, R9.1
unnamed: R13.2, RX.A
unnamed: 5V.A, R20.1
PWR_IN_12: TE_AMPSEAL_8.8 (2); also elsewhere on the board
RESET: ATMEGA328P.29 (PC6), C10.1, ICP.5, R7.1, U$2.17 (~RESET)
RX-I: ATMEGA328P.30 (PD0), R14.1
RXCAN: U$2.2 (RXCAN), U$3.4 (RXD)
RXD1: R15.2, U1.4 (RXD)
RXLED: RX.C, U1.17 (CBUS1)
SCK: ATMEGA328P.17 (PB5), ICP.3, U$2.13 (SCK); also elsewhere on the board
TX-O: ATMEGA328P.31 (PD1), R15.1
TXCAN: U$2.1 (TXCAN), U$3.1 (TXD)
TXD1: R14.2, U1.20 (TXD)
TXLED: TX.C, U1.10 (CBUS2)
XTAL1: ATMEGA328P.7 (PB6), C3.2, U$4.3 (2)
XTAL2: ATMEGA328P.8 (PB7), C4.1, U$4.1

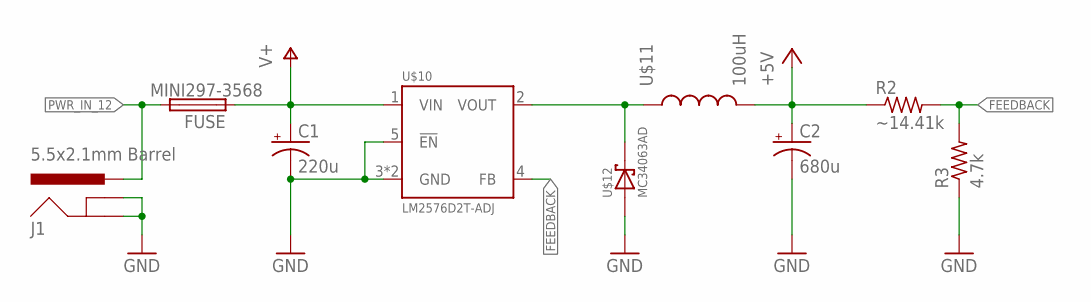
[picture p52: schematic Display_Board_v4.sch, sheet 2, <h3>Power</h3>]

Parts:
C1: 220u; UD-6,3X7,7_NICHICON
C2: 680u; UD-6,3X7,7_NICHICON
FUSE: MINI297-3568; 3568
J1: 5.5x2.1mm Barrel; POWER_JACK_SMD
R2: ~14.41k; R0603
R3: 4.7k; R0603
U$10: LM2576D2T-ADJ; TO263-5
U$11: 100uH; 12MM_12MM_INDUCTOR
U$12: MC34063AD; SMC

Connections:
+5V: C2.+, R2.1, U$11.P$2 (2); also elsewhere on the board
FEEDBACK: R2.2, R3.2, U$10.4 (FB)
GND: C1.-, C2.-, J1.GND (GNDBREAK), J1.P$4 (GND), R3.1, U$10.3 (GND), U$10.5 (!EN), U$10.6 (GND), U$12.A; also elsewhere on the board
unnamed: U$10.2 (VOUT), U$11.P$1 (1), U$12.C
PWR_IN_12: FUSE.P$2 (2), FUSE.P$3 (2), J1.VIN0 (PWR); also elsewhere on the board
V+: C1.+, FUSE.P$1 (1), FUSE.P$4 (1), U$10.1 (VIN)

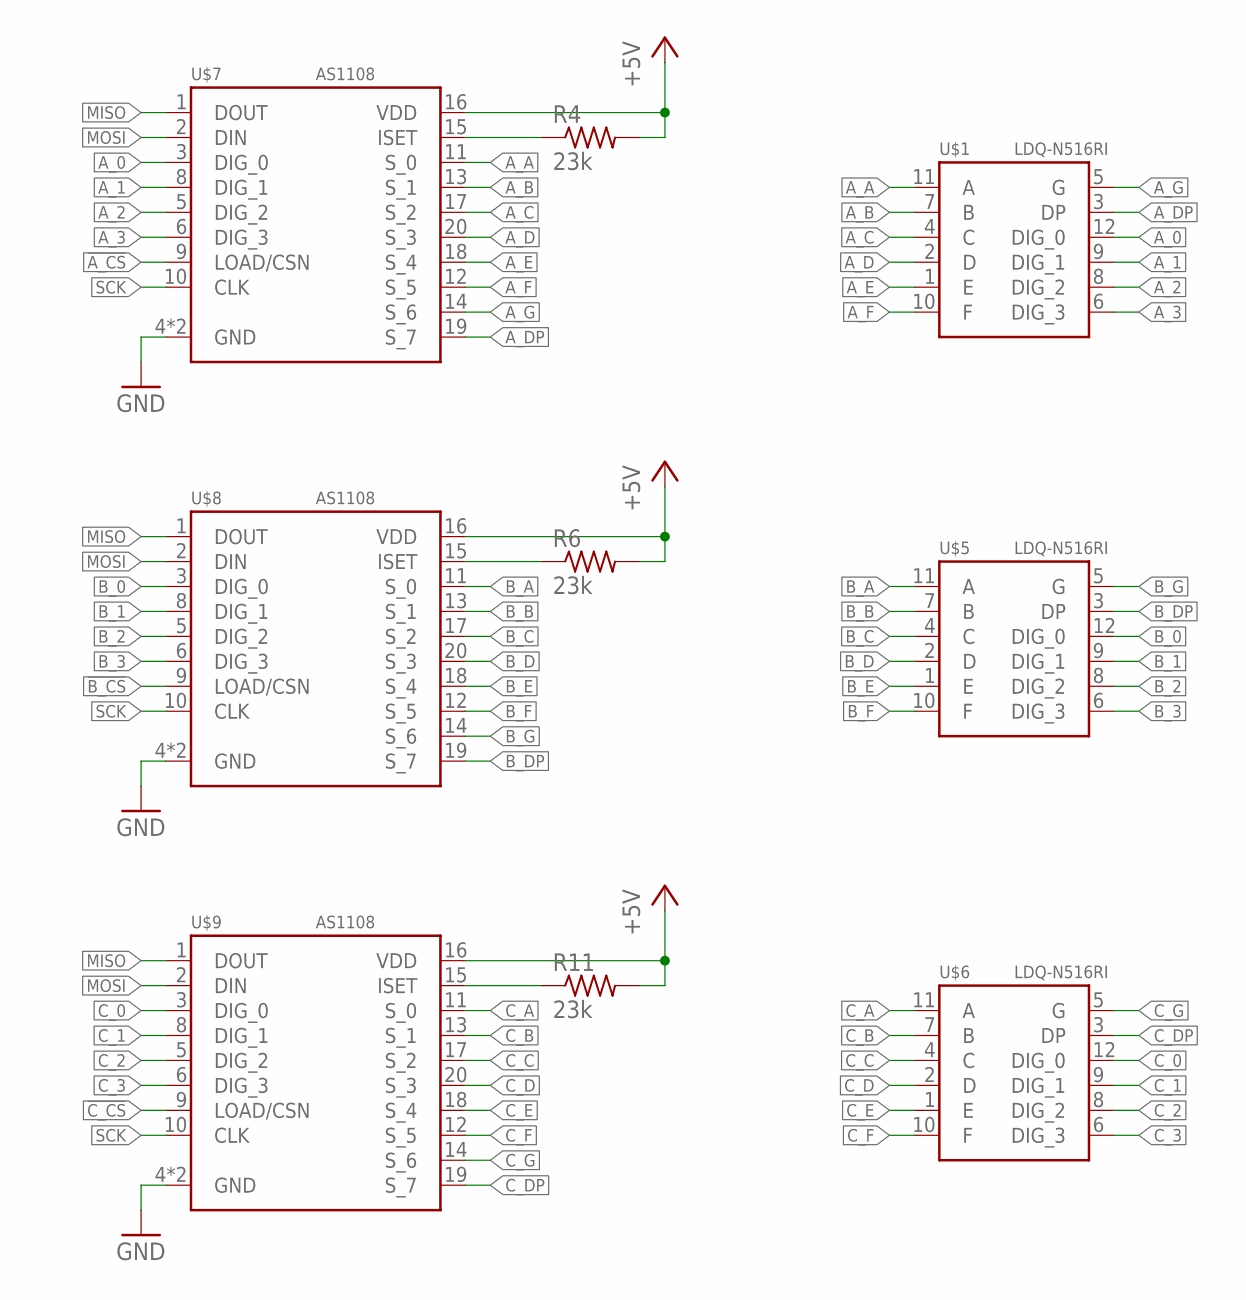
[picture p53: schematic Display_Board_v4.sch, sheet 3, Displays]

Parts:
R4, R6, R11: 23k; R0603
U$1, U$5, U$6: LDQ-N516RI; 4_DIGIT_7_SEGMENT_DISPLAY_0.56"
U$7, U$8, U$9: AS1108; SO20L

Connections:
!A_CS: U$7.9 (LOAD/CSN); also elsewhere on the board
!B_CS: U$8.9 (LOAD/CSN); also elsewhere on the board
!C_CS: U$9.9 (LOAD/CSN); also elsewhere on the board
+5V: R4.2, R6.2, R11.2, U$7.16 (VDD), U$8.16 (VDD), U$9.16 (VDD); also elsewhere on the board
A_0: U$1.12 (DIG_0), U$7.3 (DIG_0)
A_1: U$1.9 (DIG_1), U$7.8 (DIG_1)
A_2: U$1.8 (DIG_2), U$7.5 (DIG_2)
A_3: U$1.6 (DIG_3), U$7.6 (DIG_3)
A_A: U$1.11 (A), U$7.11 (S_0)
A_B: U$1.7 (B), U$7.13 (S_1)
A_C: U$1.4 (C), U$7.17 (S_2)
A_D: U$1.2 (D), U$7.20 (S_3)
A_DP: U$1.3 (DP), U$7.19 (S_7)
A_E: U$1.1 (E), U$7.18 (S_4)
A_F: U$1.10 (F), U$7.12 (S_5)
A_G: U$1.5 (G), U$7.14 (S_6)
B_0: U$5.12 (DIG_0), U$8.3 (DIG_0)
B_1: U$5.9 (DIG_1), U$8.8 (DIG_1)
B_2: U$5.8 (DIG_2), U$8.5 (DIG_2)
B_3: U$5.6 (DIG_3), U$8.6 (DIG_3)
B_A: U$5.11 (A), U$8.11 (S_0)
B_B: U$5.7 (B), U$8.13 (S_1)
B_C: U$5.4 (C), U$8.17 (S_2)
B_D: U$5.2 (D), U$8.20 (S_3)
B_DP: U$5.3 (DP), U$8.19 (S_7)
B_E: U$5.1 (E), U$8.18 (S_4)
B_F: U$5.10 (F), U$8.12 (S_5)
B_G: U$5.5 (G), U$8.14 (S_6)
C_0: U$6.12 (DIG_0), U$9.3 (DIG_0)
C_1: U$6.9 (DIG_1), U$9.8 (DIG_1)
C_2: U$6.8 (DIG_2), U$9.5 (DIG_2)
C_3: U$6.6 (DIG_3), U$9.6 (DIG_3)
C_A: U$6.11 (A), U$9.11 (S_0)
C_B: U$6.7 (B), U$9.13 (S_1)
C_C: U$6.4 (C), U$9.17 (S_2)
C_D: U$6.2 (D), U$9.20 (S_3)
C_DP: U$6.3 (DP), U$9.19 (S_7)
C_E: U$6.1 (E), U$9.18 (S_4)
C_F: U$6.10 (F), U$9.12 (S_5)
C_G: U$6.5 (G), U$9.14 (S_6)
GND: U$7.4 (GND), U$7.7 (GND), U$8.4 (GND), U$8.7 (GND), U$9.4 (GND), U$9.7 (GND); also elsewhere on the board
MISO: U$7.1 (DOUT), U$8.1 (DOUT), U$9.1 (DOUT); also elsewhere on the board
MOSI: U$7.2 (DIN), U$8.2 (DIN), U$9.2 (DIN); also elsewhere on the board
unnamed: R6.1, U$8.15 (ISET)
unnamed: R11.1, U$9.15 (ISET)
unnamed: R4.1, U$7.15 (ISET)
SCK: U$7.10 (CLK), U$8.10 (CLK), U$9.10 (CLK); also elsewhere on the board

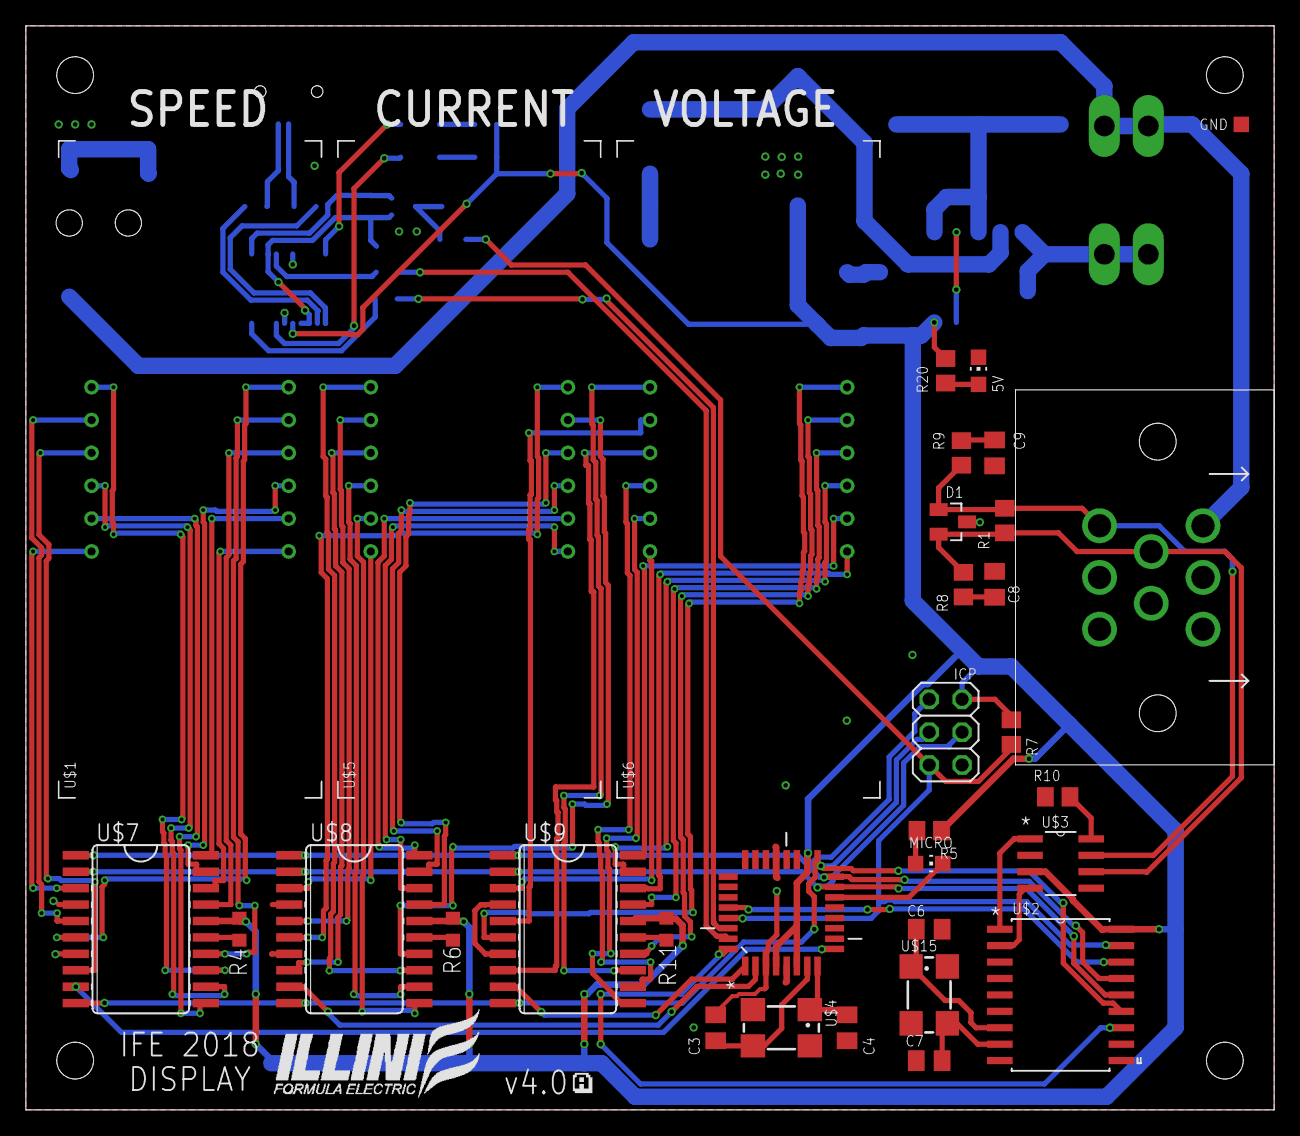
[picture p54: board Display_Board_v4.brd from above]

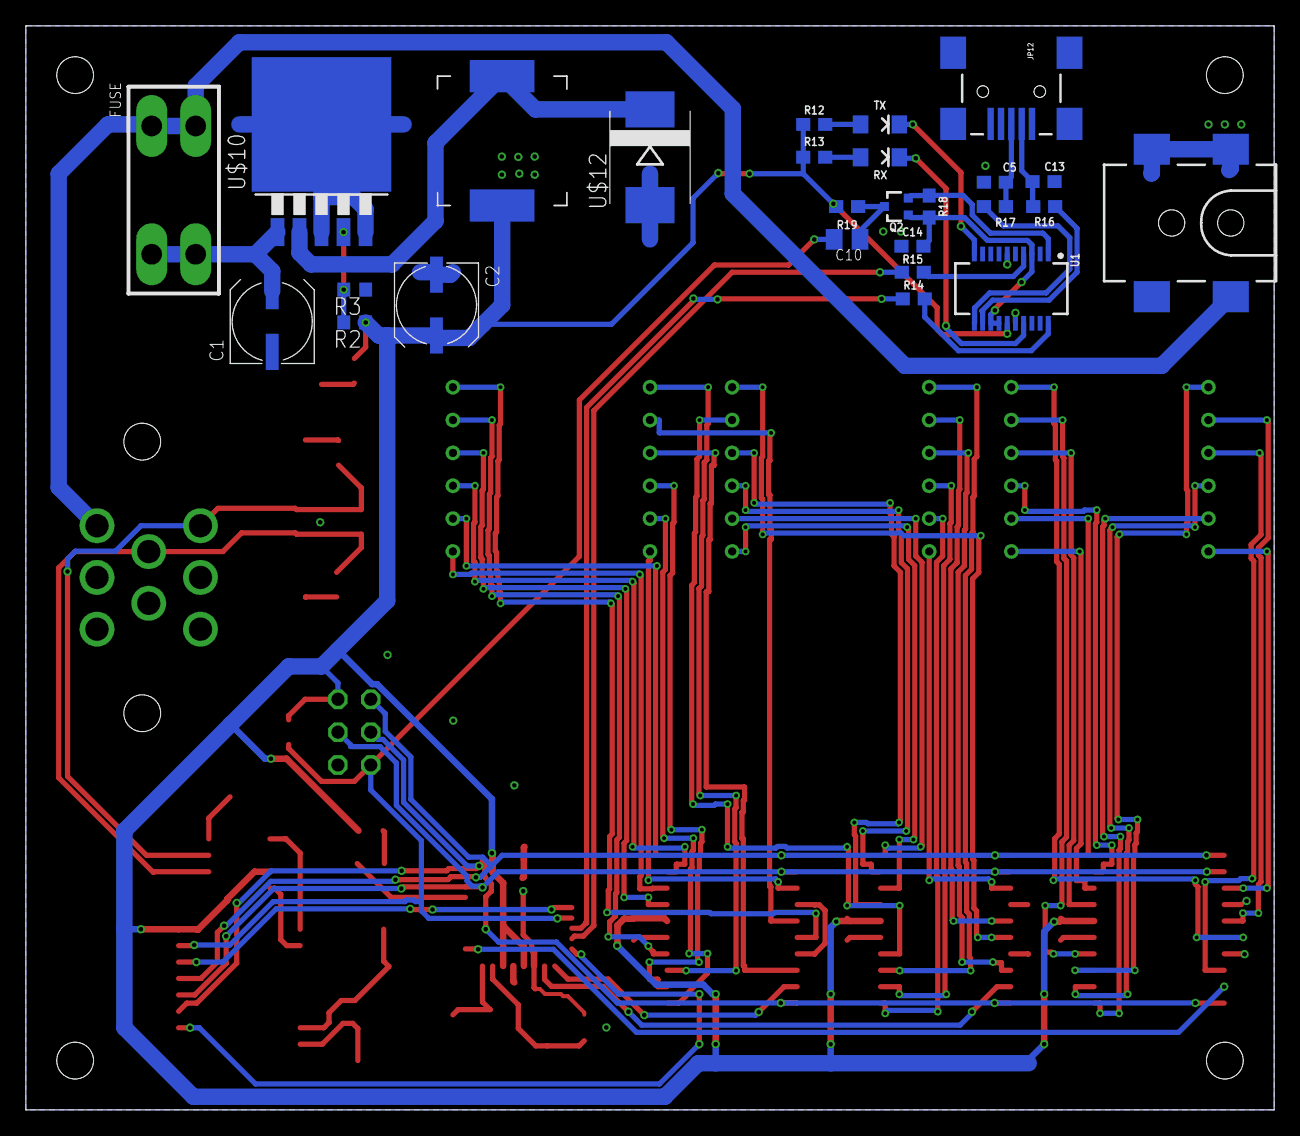
[picture p55: board Display_Board_v4.brd from below]

Board: 2 copper layers, 96.5 x 83.8 mm, 59 parts (26 on the bottom side), 83 nets.
