atsmith3/IFE_DISPLAY_2017_18/Schematics/IFE_DISPLAY/Display_Board_v3.brd

## EAGLE design Schematics/IFE_DISPLAY/Display_Board_v3.brd (2018-06-05, an earlier design)

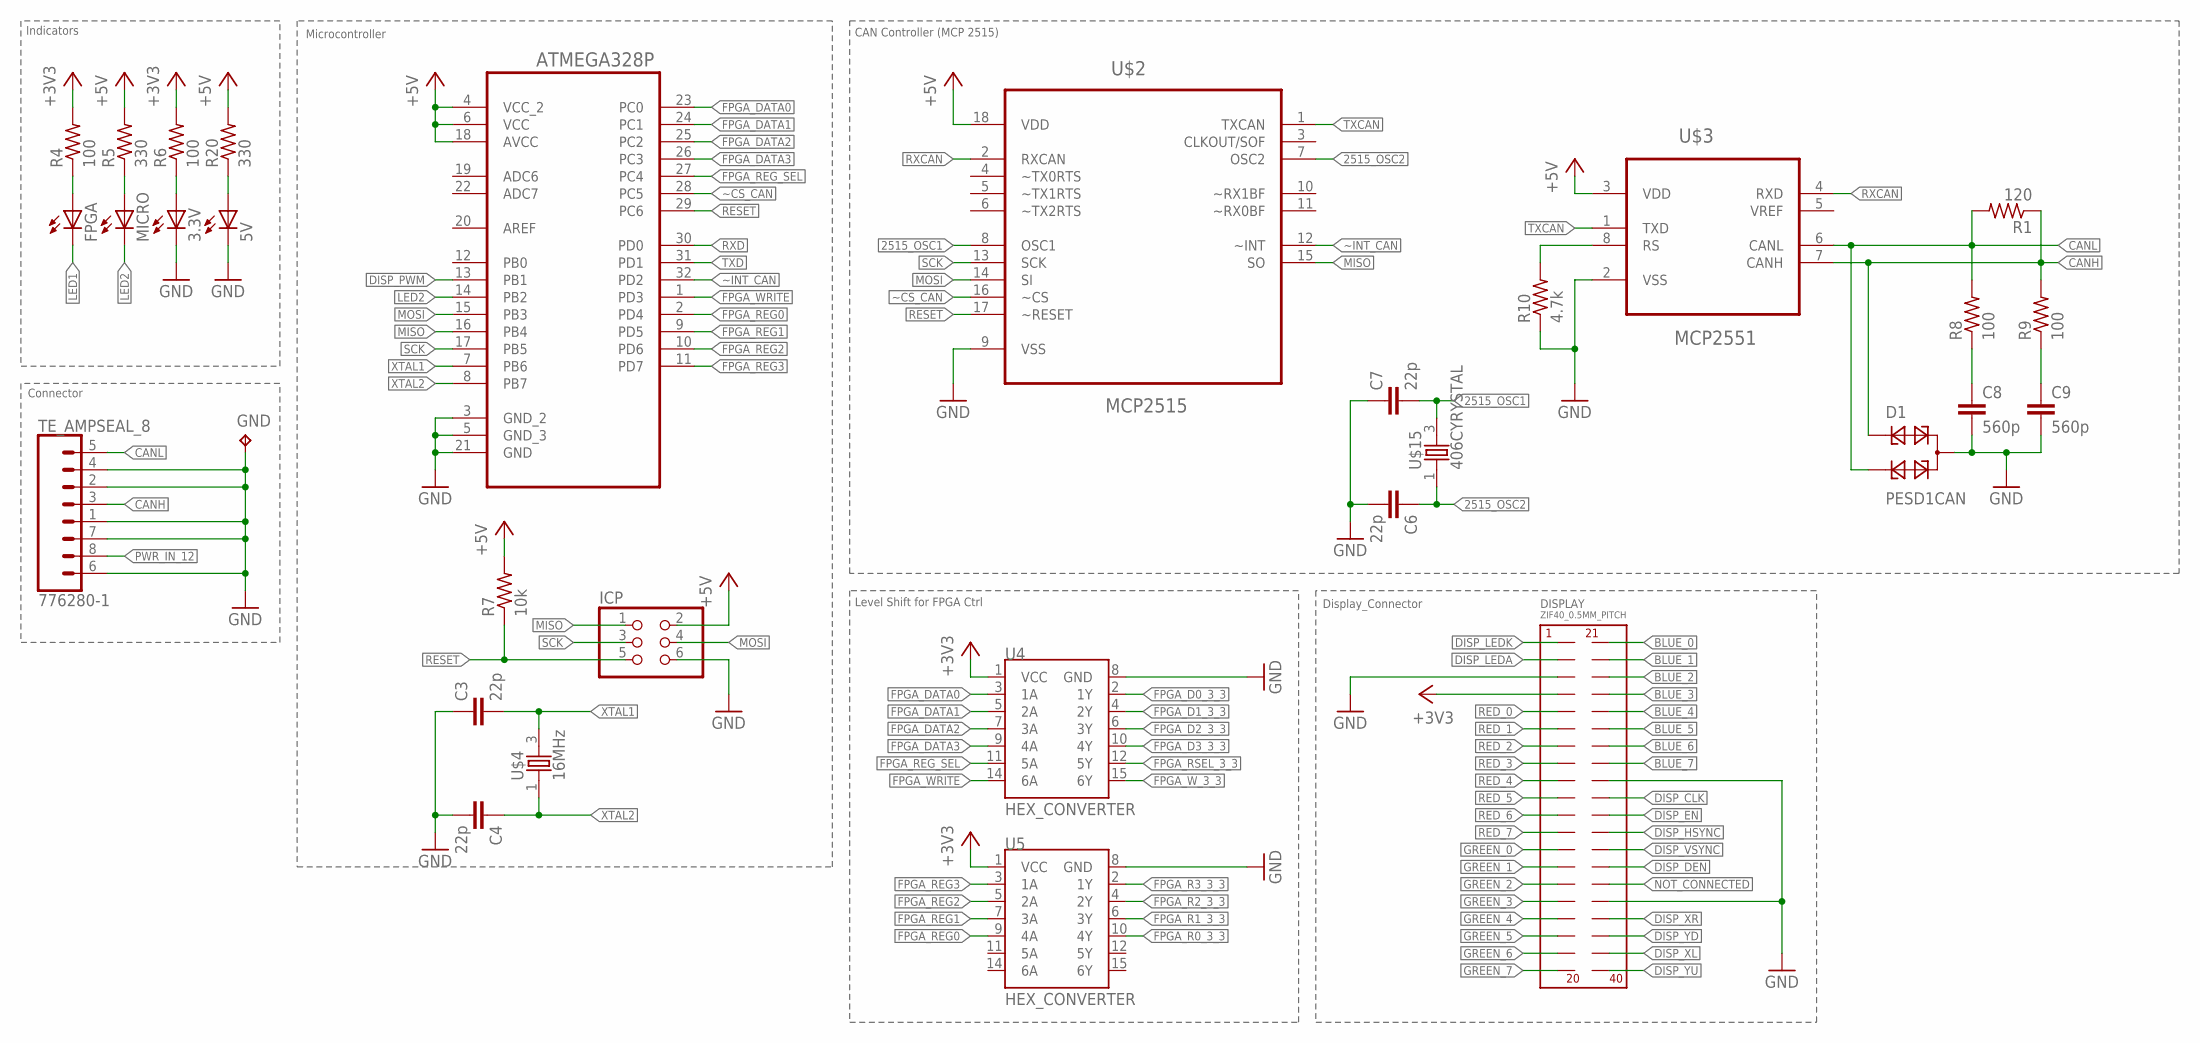
[picture p56: schematic Display_Board_v3.sch, sheet 1, <h3>Micro and CAN</h3>]

Parts:
3.3V, 5V: LEDCHIP-LED0805; CHIP-LED0805
ATMEGA328P: ATMEGA328P-AU; QFP80P900X900X120-32N
C3, C4, C6, C7: 22p; C0805K
C8, C9: 560p; C0805K
D1: PESD1CAN; SOT23
DISPLAY: ZIF40_0.5MM_PITCH; ZIF40
FPGA: LEDCHIP-LED0805; CHIP-LED0805
GND: TPTP12SQ; TP12SQ
ICP: PINHD-2X3; 2X03
MICRO: LEDCHIP-LED0805; CHIP-LED0805
R1: 120; R0805
R4, R6, R8, R9: 100; R0805
R5, R20: 330; R0805
R7: 10k; R0805
R10: 4.7k; R0805
TE_AMPSEAL_8: 776280-1
U4, U5: HEX_CONVERTER; SO016
U$2: MCP2515; SOIC127P1034X264-18N
U$3: MCP2551; SOIC127P600X175-8N
U$4: 16MHz; CTS406
U$15: 406CYRYSTAL; CTS406

Connections:
2515_OSC1: C7.2, U$2.8 (OSC1), U$15.3 (2)
2515_OSC2: C6.1, U$2.7 (OSC2), U$15.1
+3V3: DISPLAY.P$4, R4.2, R6.2, U4.1 (VCC), U5.1 (VCC); also elsewhere on the board
+5V: ATMEGA328P.4 (VCC_2), ATMEGA328P.6 (VCC), ATMEGA328P.18 (AVCC), ICP.2, R5.2, R7.2, R20.2, U$2.18 (VDD), U$3.3 (VDD); also elsewhere on the board
BLUE_0: DISPLAY.P$21; also elsewhere on the board
BLUE_1: DISPLAY.P$22; also elsewhere on the board
BLUE_2: DISPLAY.P$23; also elsewhere on the board
BLUE_3: DISPLAY.P$24; also elsewhere on the board
BLUE_4: DISPLAY.P$25; also elsewhere on the board
BLUE_5: DISPLAY.P$26; also elsewhere on the board
BLUE_6: DISPLAY.P$27; also elsewhere on the board
BLUE_7: DISPLAY.P$28; also elsewhere on the board
CANH: D1.1, R1.1, R9.2, TE_AMPSEAL_8.3 (5), U$3.7 (CANH)
CANL: D1.2, R1.2, R8.2, TE_AMPSEAL_8.5 (8), U$3.6 (CANL)
DISP_CLK: DISPLAY.P$30; also elsewhere on the board
DISP_DEN: DISPLAY.P$34; also elsewhere on the board
DISP_EN: DISPLAY.P$31; also elsewhere on the board
DISP_HSYNC: DISPLAY.P$32; also elsewhere on the board
DISP_LEDA: DISPLAY.P$2; also elsewhere on the board
DISP_LEDK: DISPLAY.P$1; also elsewhere on the board
DISP_PWM: ATMEGA328P.13 (PB1); also elsewhere on the board
DISP_VSYNC: DISPLAY.P$33; also elsewhere on the board
DISP_XL: DISPLAY.P$39
DISP_XR: DISPLAY.P$37
DISP_YD: DISPLAY.P$38
DISP_YU: DISPLAY.P$40
FPGA_D0_3_3: U4.2 (1Y); also elsewhere on the board
FPGA_D1_3_3: U4.4 (2Y); also elsewhere on the board
FPGA_D2_3_3: U4.6 (3Y); also elsewhere on the board
FPGA_D3_3_3: U4.10 (4Y); also elsewhere on the board
FPGA_DATA0: ATMEGA328P.23 (PC0), U4.3 (1A)
FPGA_DATA1: ATMEGA328P.24 (PC1), U4.5 (2A)
FPGA_DATA2: ATMEGA328P.25 (PC2), U4.7 (3A)
FPGA_DATA3: ATMEGA328P.26 (PC3), U4.9 (4A)
FPGA_R0_3_3: U5.10 (4Y); also elsewhere on the board
FPGA_R1_3_3: U5.6 (3Y); also elsewhere on the board
FPGA_R2_3_3: U5.4 (2Y); also elsewhere on the board
FPGA_R3_3_3: U5.2 (1Y); also elsewhere on the board
FPGA_REG0: ATMEGA328P.2 (PD4), U5.9 (4A)
FPGA_REG1: ATMEGA328P.9 (PD5), U5.7 (3A)
FPGA_REG2: ATMEGA328P.10 (PD6), U5.5 (2A)
FPGA_REG3: ATMEGA328P.11 (PD7), U5.3 (1A)
FPGA_REG_SEL: ATMEGA328P.27 (PC4), U4.11 (5A)
FPGA_RSEL_3_3: U4.12 (5Y); also elsewhere on the board
FPGA_WRITE: ATMEGA328P.1 (PD3), U4.14 (6A)
FPGA_W_3_3: U4.15 (6Y); also elsewhere on the board
GND: 3.3V.C, 5V.C, ATMEGA328P.3 (GND_2), ATMEGA328P.5 (GND_3), ATMEGA328P.21 (GND), C3.1, C4.2, C6.2, C7.1, C8.2, C9.2, D1.3, DISPLAY.P$3, DISPLAY.P$29, DISPLAY.P$36, GND.TP, ICP.6, R10.1, TE_AMPSEAL_8.1 (4), TE_AMPSEAL_8.2 (6), TE_AMPSEAL_8.4 (7), TE_AMPSEAL_8.6 (1), TE_AMPSEAL_8.7 (3), U4.8 (GND), U5.8 (GND), U$2.9 (VSS), U$3.2 (VSS); also elsewhere on the board
GREEN_0: DISPLAY.P$13; also elsewhere on the board
GREEN_1: DISPLAY.P$14; also elsewhere on the board
GREEN_2: DISPLAY.P$15; also elsewhere on the board
GREEN_3: DISPLAY.P$16; also elsewhere on the board
GREEN_4: DISPLAY.P$17; also elsewhere on the board
GREEN_5: DISPLAY.P$18; also elsewhere on the board
GREEN_6: DISPLAY.P$19; also elsewhere on the board
GREEN_7: DISPLAY.P$20; also elsewhere on the board
LED1: FPGA.C; also elsewhere on the board
LED2: ATMEGA328P.14 (PB2), MICRO.C
MISO: ATMEGA328P.16 (PB4), ICP.1, U$2.15 (SO)
MOSI: ATMEGA328P.15 (PB3), ICP.4, U$2.14 (SI)
unnamed: FPGA.A, R4.1
unnamed: MICRO.A, R5.1
unnamed: 3.3V.A, R6.1
unnamed: R10.2, U$3.8 (RS)
unnamed: C8.1, R8.1
unnamed: C9.1, R9.1
unnamed: 5V.A, R20.1
NOT_CONNECTED: DISPLAY.P$35
PWR_IN_12: TE_AMPSEAL_8.8 (2); also elsewhere on the board
RED_0: DISPLAY.P$5; also elsewhere on the board
RED_1: DISPLAY.P$6; also elsewhere on the board
RED_2: DISPLAY.P$7; also elsewhere on the board
RED_3: DISPLAY.P$8; also elsewhere on the board
RED_4: DISPLAY.P$9; also elsewhere on the board
RED_5: DISPLAY.P$10; also elsewhere on the board
RED_6: DISPLAY.P$11; also elsewhere on the board
RED_7: DISPLAY.P$12; also elsewhere on the board
RESET: ATMEGA328P.29 (PC6), ICP.5, R7.1, U$2.17 (~RESET)
RXCAN: U$2.2 (RXCAN), U$3.4 (RXD)
RXD: ATMEGA328P.30 (PD0)
SCK: ATMEGA328P.17 (PB5), ICP.3, U$2.13 (SCK)
TXCAN: U$2.1 (TXCAN), U$3.1 (TXD)
TXD: ATMEGA328P.31 (PD1)
XTAL1: ATMEGA328P.7 (PB6), C3.2, U$4.3 (2)
XTAL2: ATMEGA328P.8 (PB7), C4.1, U$4.1
~CS_CAN: ATMEGA328P.28 (PC5), U$2.16 (~CS)
~INT_CAN: ATMEGA328P.32 (PD2), U$2.12 (~INT)

Notes on the sheet:
Microcontroller
CAN Controller (MCP 2515)
Indicators
Level Shift for FPGA Ctrl
Connector
Display_Connector

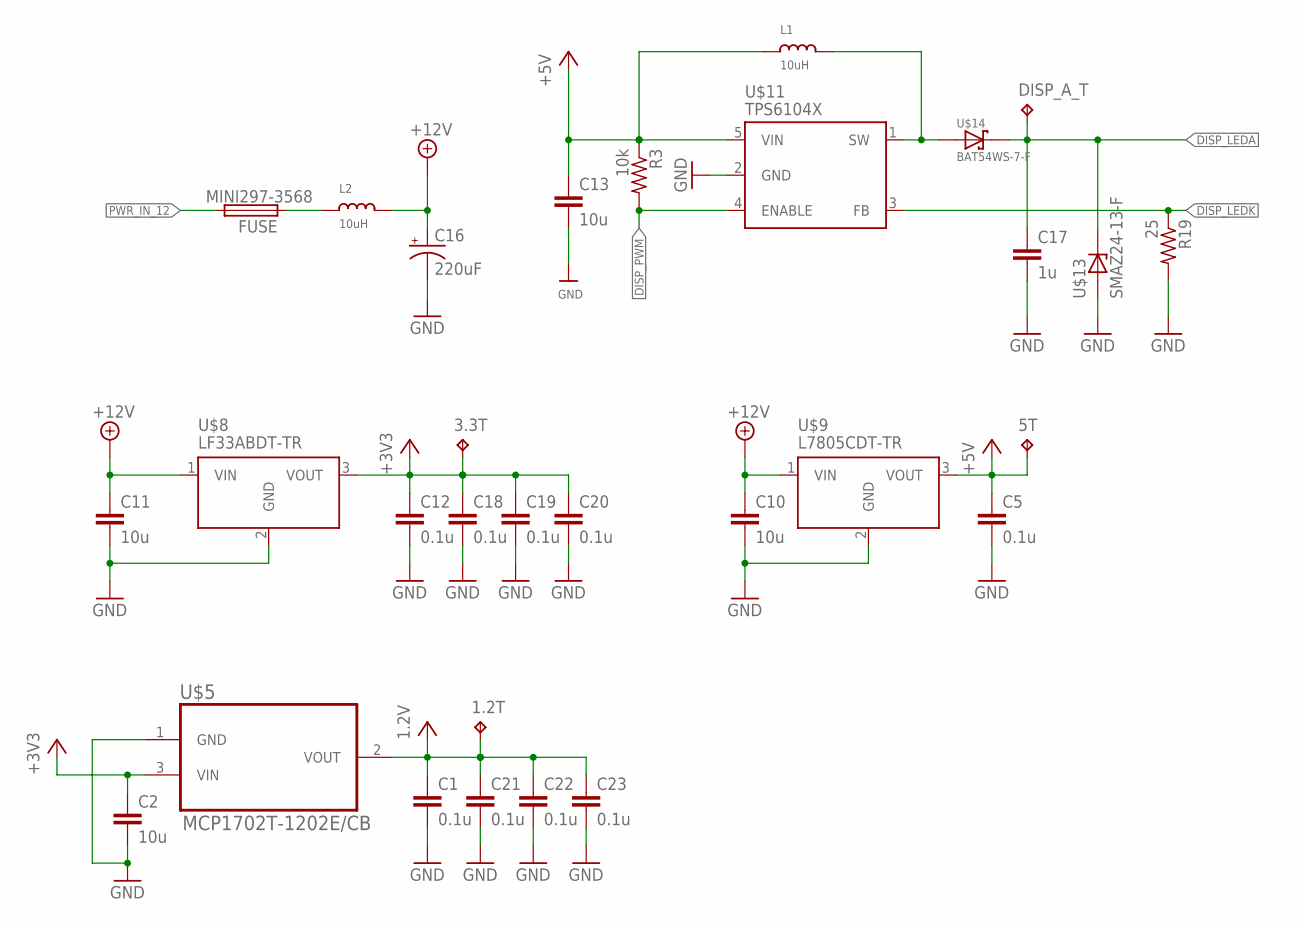
[picture p57: schematic Display_Board_v3.sch, sheet 2, <h3>Power</h3>]

Parts:
1.2T, 3.3T, 5T: TPTP12SQ; TP12SQ
C1, C5, C12, C18, C19, C20, C21, C22, C23: 0.1u; C0805K
C2, C10, C11, C13: 10u; C0805K
C16: 220uF; UD-6,3X7,7_NICHICON
C17: 1u; C0805K
DISP_A_T: TPTP12SQ; TP12SQ
FUSE: MINI297-3568; 3568
L1, L2: 10uH; INDUCTOR_5X5MM_NR5040_NOTHERMALS
R3: 10k; R0805
R19: 25; R0805
U$5: MCP1702T-1202E/CB; SOT95P300X145-3N
U$8: LF33ABDT-TR; DPACK
U$9: L7805CDT-TR; DPACK
U$11: TPS6104X; SOT23-5L
U$13: SMAZ24-13-F; SMA_DIODE
U$14: BAT54WS-7-F; SOD323

Connections:
+3V3: 3.3T.TP, C2.1, C12.1, C18.1, C19.1, C20.1, U$5.3 (VIN), U$8.3 (VOUT); also elsewhere on the board
+5V: 5T.TP, C5.1, C13.1, L1.P$1 (1), R3.1, U$9.3 (VOUT), U$11.5 (VIN); also elsewhere on the board
+12V: C10.1, C11.1, C16.+, L2.P$2 (2), U$8.1 (VIN), U$9.1 (VIN)
DISP_LEDA: C17.1, DISP_A_T.TP, U$13.C, U$14.1 (C); also elsewhere on the board
DISP_LEDK: R19.1, U$11.3 (FB); also elsewhere on the board
DISP_PWM: R3.2, U$11.4 (ENABLE); also elsewhere on the board
GND: C1.2, C2.2, C5.2, C10.2, C11.2, C12.2, C13.2, C16.-, C17.2, C18.2, C19.2, C20.2, C21.2, C22.2, C23.2, R19.2, U$5.1 (GND), U$8.2 (GND), U$9.2 (GND), U$11.2 (GND), U$13.A; also elsewhere on the board
unnamed: FUSE.P$1 (1), FUSE.P$4 (1), L2.P$1 (1)
unnamed: L1.P$2 (2), U$11.1 (SW), U$14.2 (A)
PWR_IN_12: FUSE.P$2 (2), FUSE.P$3 (2); also elsewhere on the board
VCC: 1.2T.TP, C1.1, C21.1, C22.1, C23.1, U$5.2 (VOUT); also elsewhere on the board

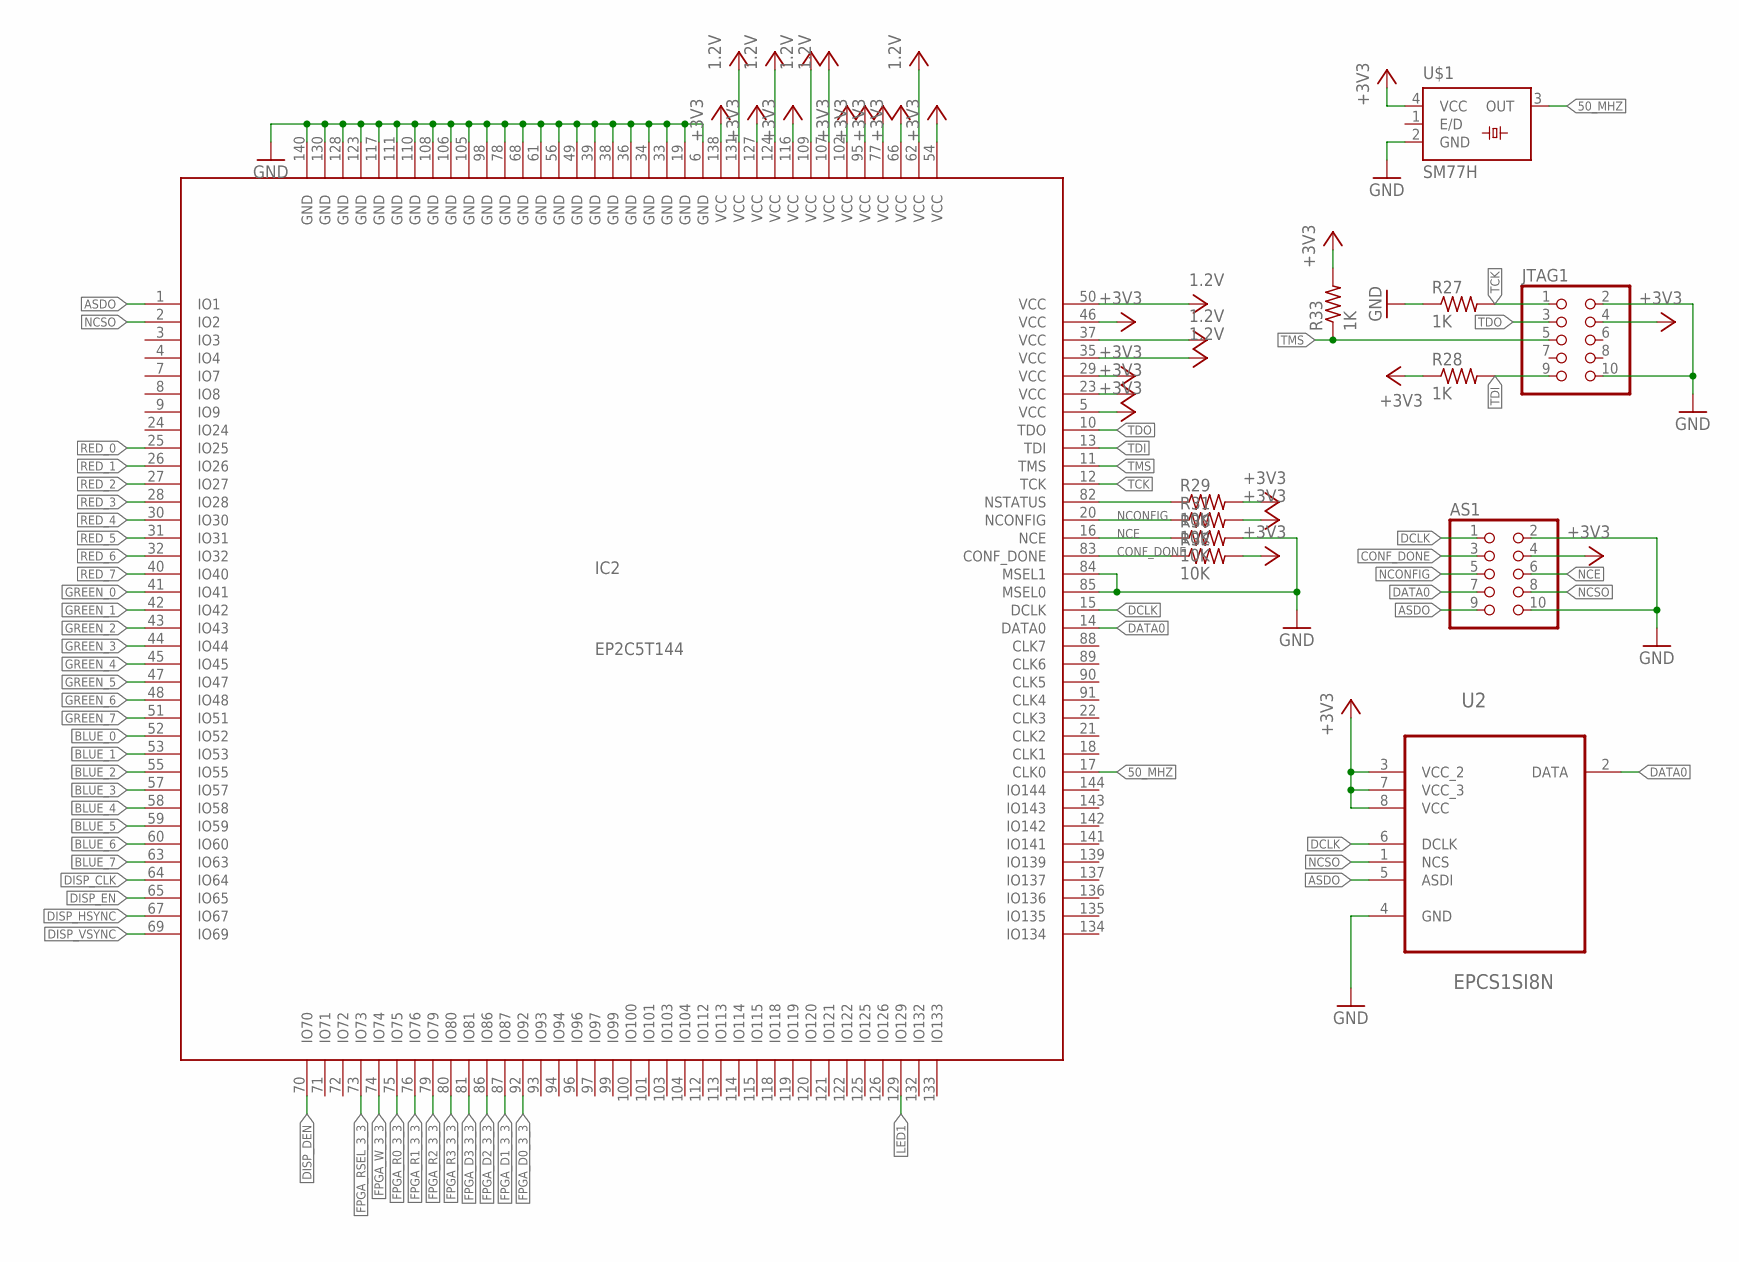
[picture p58: schematic Display_Board_v3.sch, sheet 3, Cyclone 2 FPGA]

Parts:
AS1: PINHD-2X5; 2X05
IC2: EP2C5T144; TQFP144
JTAG1: PINHD-2X5; 2X05
R27, R28, R33: 1K; R0805
R29, R30, R31, R32: 10K; R0805
U2: EPCS1SI8N; SOIC127P600X175-8N
U$1: SM77H

Connections:
50_MHZ: IC2.17 (CLK0), U$1.3 (OUT)
+3V3: AS1.4, IC2.5 (VCC), IC2.23 (VCC), IC2.29 (VCC), IC2.46 (VCC), IC2.54 (VCC), IC2.66 (VCC), IC2.77 (VCC), IC2.95 (VCC), IC2.102 (VCC), IC2.116 (VCC), IC2.127 (VCC), IC2.138 (VCC), JTAG1.4, R28.1, R29.2, R31.2, R32.2, R33.2, U2.3 (VCC_2), U2.7 (VCC_3), U2.8 (VCC), U$1.4 (VCC); also elsewhere on the board
ASDO: AS1.9, IC2.1 (IO1), U2.5 (ASDI)
BLUE_0: IC2.52 (IO52); also elsewhere on the board
BLUE_1: IC2.53 (IO53); also elsewhere on the board
BLUE_2: IC2.55 (IO55); also elsewhere on the board
BLUE_3: IC2.57 (IO57); also elsewhere on the board
BLUE_4: IC2.58 (IO58); also elsewhere on the board
BLUE_5: IC2.59 (IO59); also elsewhere on the board
BLUE_6: IC2.60 (IO60); also elsewhere on the board
BLUE_7: IC2.63 (IO63); also elsewhere on the board
CONF_DONE: AS1.3, IC2.83 (CONF_DONE), R32.1
DATA0: AS1.7, IC2.14 (DATA0), U2.2 (DATA)
DCLK: AS1.1, IC2.15 (DCLK), U2.6 (DCLK)
DISP_CLK: IC2.64 (IO64); also elsewhere on the board
DISP_DEN: IC2.70 (IO70); also elsewhere on the board
DISP_EN: IC2.65 (IO65); also elsewhere on the board
DISP_HSYNC: IC2.67 (IO67); also elsewhere on the board
DISP_VSYNC: IC2.69 (IO69); also elsewhere on the board
FPGA_D0_3_3: IC2.92 (IO92); also elsewhere on the board
FPGA_D1_3_3: IC2.87 (IO87); also elsewhere on the board
FPGA_D2_3_3: IC2.86 (IO86); also elsewhere on the board
FPGA_D3_3_3: IC2.81 (IO81); also elsewhere on the board
FPGA_R0_3_3: IC2.75 (IO75); also elsewhere on the board
FPGA_R1_3_3: IC2.76 (IO76); also elsewhere on the board
FPGA_R2_3_3: IC2.79 (IO79); also elsewhere on the board
FPGA_R3_3_3: IC2.80 (IO80); also elsewhere on the board
FPGA_RSEL_3_3: IC2.73 (IO73); also elsewhere on the board
FPGA_W_3_3: IC2.74 (IO74); also elsewhere on the board
GND: AS1.2, AS1.10, IC2.6 (GND), IC2.19 (GND), IC2.33 (GND), IC2.34 (GND), IC2.36 (GND), IC2.38 (GND), IC2.39 (GND), IC2.49 (GND), IC2.56 (GND), IC2.61 (GND), IC2.68 (GND), IC2.78 (GND), IC2.84 (MSEL1), IC2.85 (MSEL0), IC2.98 (GND), IC2.105 (GND), IC2.106 (GND), IC2.108 (GND), IC2.110 (GND), IC2.111 (GND), IC2.117 (GND), IC2.123 (GND), IC2.128 (GND), IC2.130 (GND), IC2.140 (GND), JTAG1.2, JTAG1.10, R27.1, R30.2, U2.4 (GND), U$1.2 (GND); also elsewhere on the board
GREEN_0: IC2.41 (IO41); also elsewhere on the board
GREEN_1: IC2.42 (IO42); also elsewhere on the board
GREEN_2: IC2.43 (IO43); also elsewhere on the board
GREEN_3: IC2.44 (IO44); also elsewhere on the board
GREEN_4: IC2.45 (IO45); also elsewhere on the board
GREEN_5: IC2.47 (IO47); also elsewhere on the board
GREEN_6: IC2.48 (IO48); also elsewhere on the board
GREEN_7: IC2.51 (IO51); also elsewhere on the board
LED1: IC2.129 (IO129); also elsewhere on the board
unnamed: IC2.82 (NSTATUS), R29.1
NCE: AS1.6, IC2.16 (NCE), R30.1
NCONFIG: AS1.5, IC2.20 (NCONFIG), R31.1
NCSO: AS1.8, IC2.2 (IO2), U2.1 (NCS)
RED_0: IC2.25 (IO25); also elsewhere on the board
RED_1: IC2.26 (IO26); also elsewhere on the board
RED_2: IC2.27 (IO27); also elsewhere on the board
RED_3: IC2.28 (IO28); also elsewhere on the board
RED_4: IC2.30 (IO30); also elsewhere on the board
RED_5: IC2.31 (IO31); also elsewhere on the board
RED_6: IC2.32 (IO32); also elsewhere on the board
RED_7: IC2.40 (IO40); also elsewhere on the board
TCK: IC2.12 (TCK), JTAG1.1, R27.2
TDI: IC2.13 (TDI), JTAG1.9, R28.2
TDO: IC2.10 (TDO), JTAG1.3
TMS: IC2.11 (TMS), JTAG1.5, R33.1
VCC: IC2.35 (VCC), IC2.37 (VCC), IC2.50 (VCC), IC2.62 (VCC), IC2.107 (VCC), IC2.109 (VCC), IC2.124 (VCC), IC2.131 (VCC); also elsewhere on the board
