atsmith3/IFE_DISPLAY_2017_18/Schematics/IFE_DISPLAY/Display_Board_v3.brd

## EAGLE design Schematics/IFE_DISPLAY/Display_Board_v3.brd (continued)

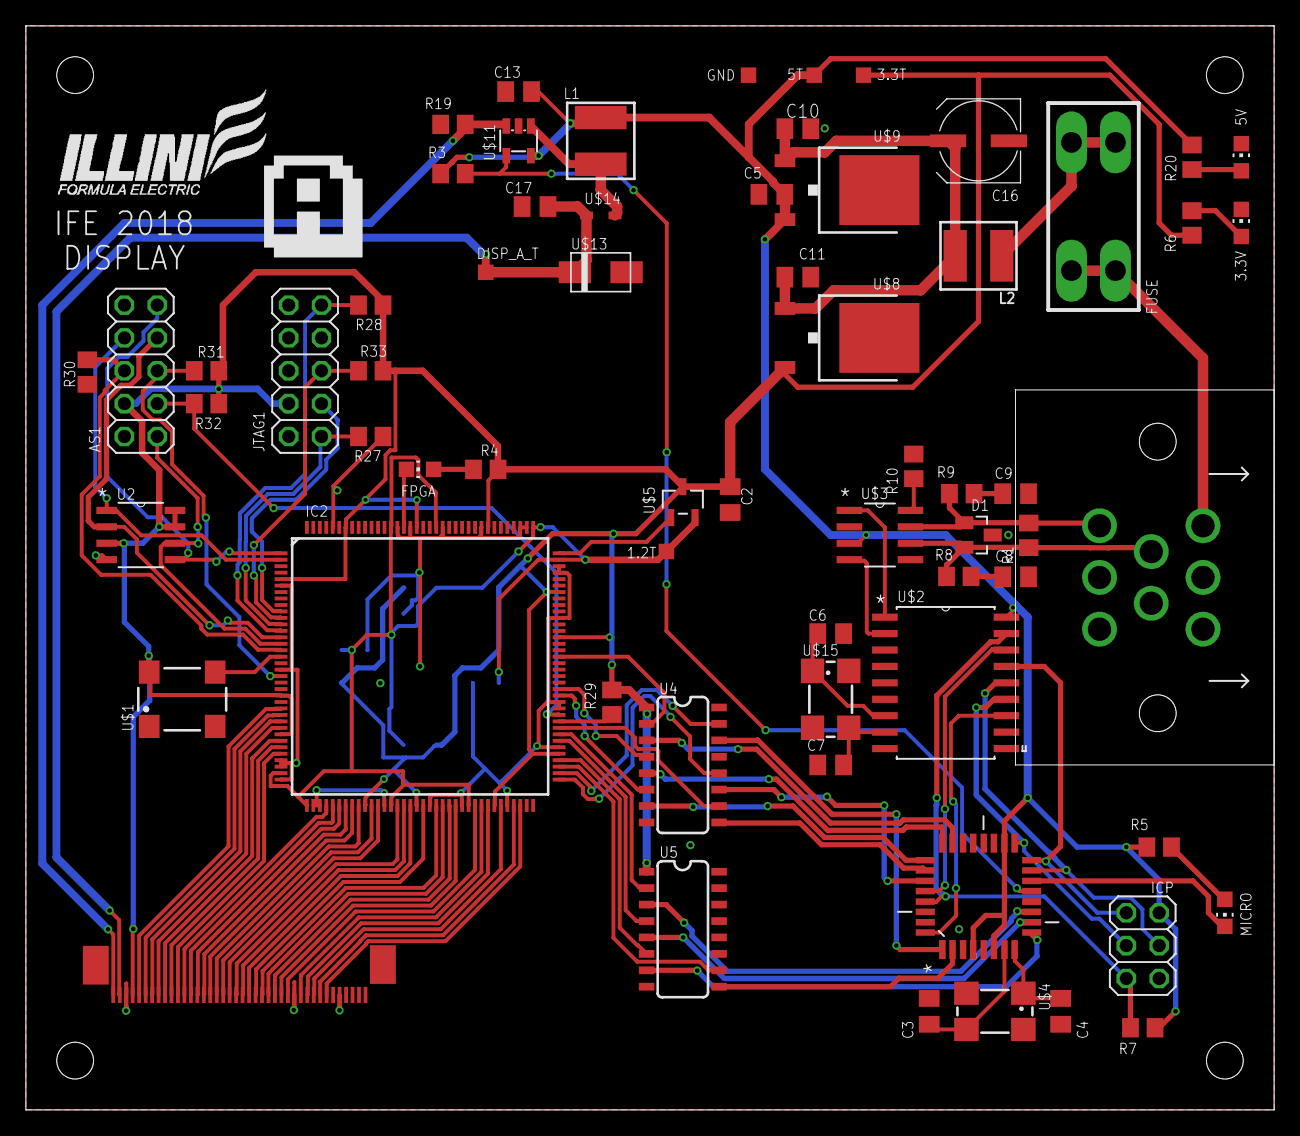
[picture p59: board Display_Board_v3.brd from above]

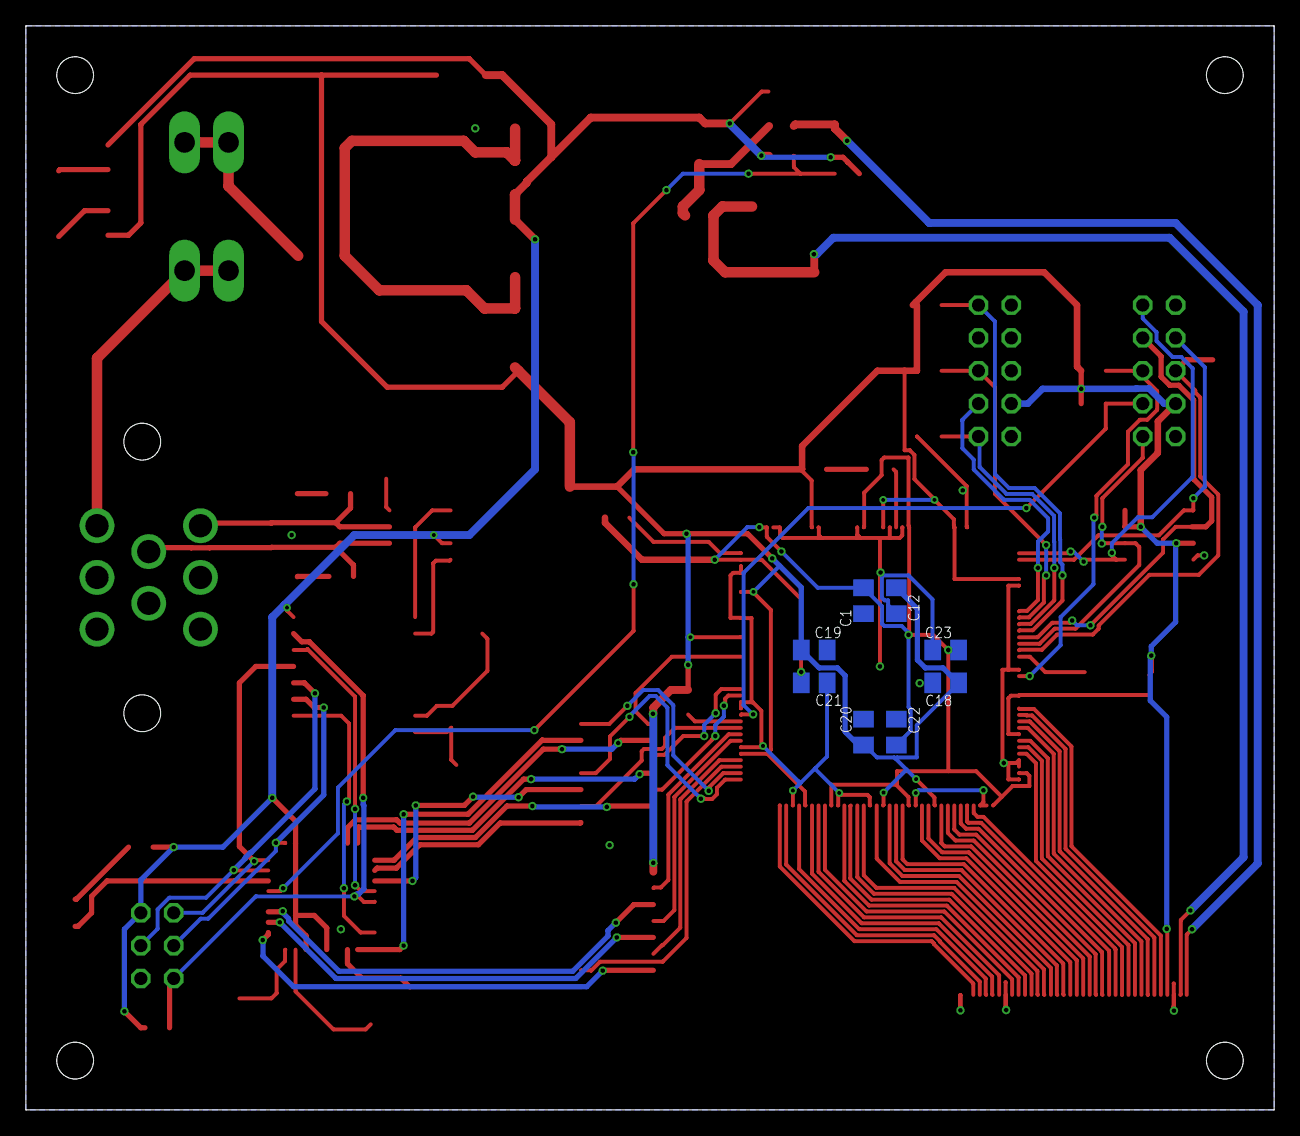
[picture p60: board Display_Board_v3.brd from below]

Board: 2 copper layers, 96.5 x 83.8 mm, 73 parts (8 on the bottom side), 96 nets.
