atsmith3/IFE_DISPLAY_2017_18/Schematics/IFE_DISPLAY/led_boost_test.brd

## EAGLE design Schematics/IFE_DISPLAY/led_boost_test.brd (2018-03-27)

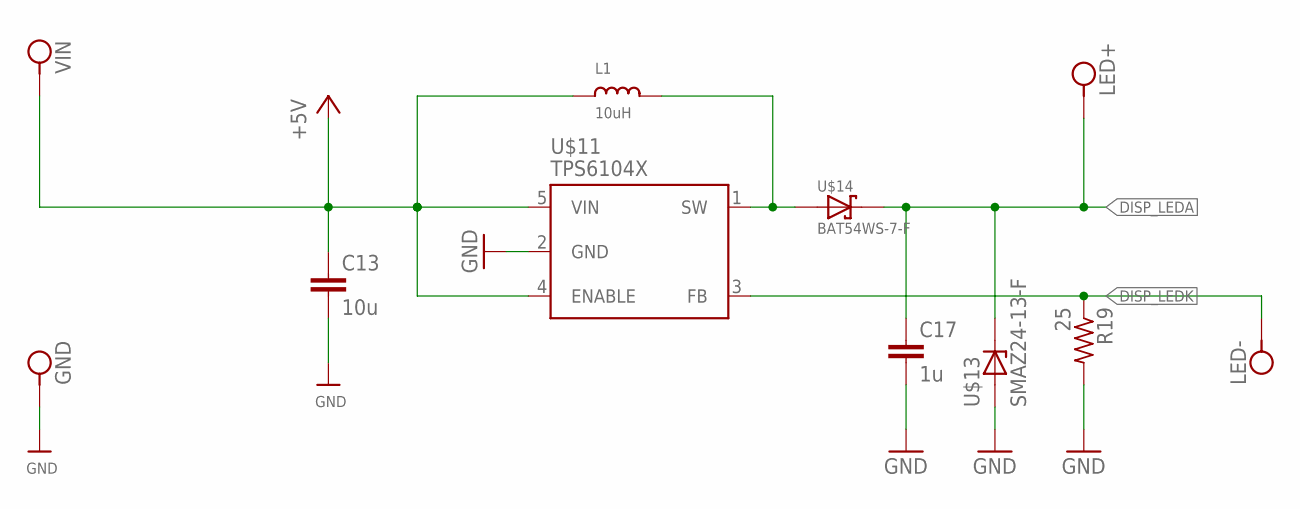
[picture p61: schematic led_boost_test.sch]

Parts:
C13: 10u; C0805K
C17: 1u; C0805K
GND: MOTOR_PAD
L1: 10uH; INDUCTOR_5X5MM_NR5040_NOTHERMALS
LED+: MOTOR_PAD
LED-: MOTOR_PAD
R19: 25; R0805
U$11: TPS6104X; SOT23-5L
U$13: SMAZ24-13-F; SMA_DIODE
U$14: BAT54WS-7-F; SOD323
VIN: MOTOR_PAD

Connections:
+5V: C13.1, L1.P$1 (1), U$11.4 (ENABLE), U$11.5 (VIN), VIN.P$1
DISP_LEDA: C17.1, LED+.P$1, U$13.C, U$14.1 (C)
DISP_LEDK: LED-.P$1, R19.1, U$11.3 (FB)
GND: C13.2, C17.2, GND.P$1, R19.2, U$11.2 (GND), U$13.A
unnamed: L1.P$2 (2), U$11.1 (SW), U$14.2 (A)

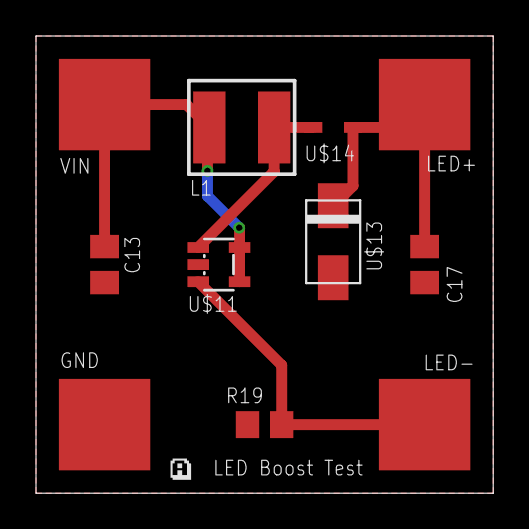
[picture p62: board led_boost_test.brd from above]

Board: 2 copper layers, 25.4 x 25.4 mm, 11 parts (0 on the bottom side), 5 nets.
