atsmith3/IFE_DISPLAY_2017_18/Schematics/IFE_DISPLAY/display_breakout.brd

## EAGLE design Schematics/IFE_DISPLAY/display_breakout.brd (2017-10-15)

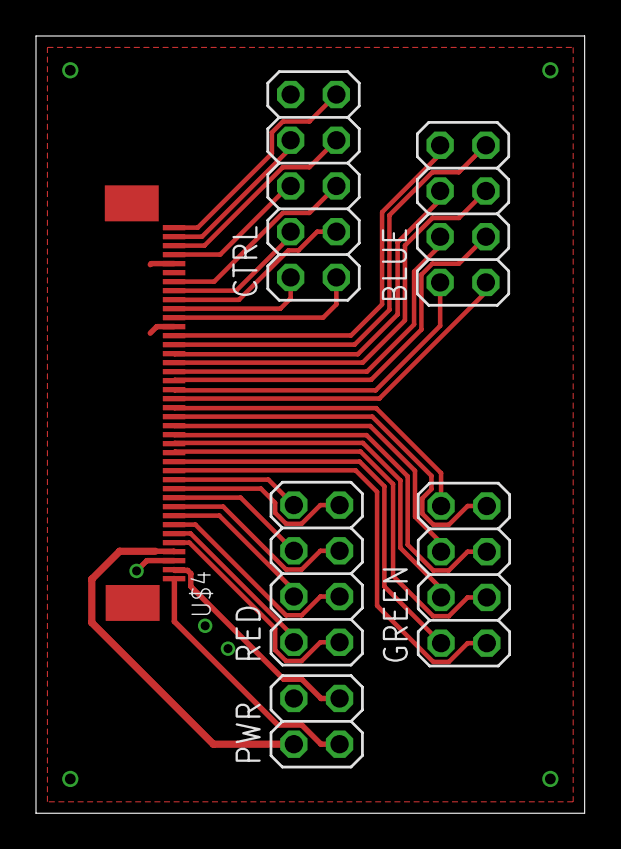
[picture p66: board display_breakout.brd from above]

Board: 2 copper layers, 30.5 x 43.2 mm, 6 parts (0 on the bottom side), 37 nets.

Parts:
BLUE: 2X04
CTRL: 2X05
GREEN: 2X04
PWR: 2X02
RED: 2X04
U$4: ZIF40_0.5MM_PITCH; ZIF40

Connections:
+3V3: PWR.2, U$4.P$4
BLUE_0: BLUE.1, U$4.P$21
BLUE_1: BLUE.2, U$4.P$22
BLUE_2: BLUE.3, U$4.P$23
BLUE_3: BLUE.4, U$4.P$24
BLUE_4: BLUE.5, U$4.P$25
BLUE_5: BLUE.6, U$4.P$26
BLUE_6: BLUE.7, U$4.P$27
BLUE_7: BLUE.8, U$4.P$28
DISP_CLK: CTRL.1, U$4.P$30
DISP_DEN: CTRL.5, U$4.P$34
DISP_EN: CTRL.2, U$4.P$31
DISP_HSYNC: CTRL.3, U$4.P$32
DISP_LEDA: PWR.3, U$4.P$2
DISP_LEDK: PWR.1, U$4.P$1
DISP_VSYNC: CTRL.4, U$4.P$33
DISP_XL: CTRL.8, U$4.P$39
DISP_XR: CTRL.6, U$4.P$37
DISP_YD: CTRL.7, U$4.P$38
DISP_YU: CTRL.9, U$4.P$40
GND: PWR.4, U$4.P$3, U$4.P$29, U$4.P$36
GREEN_0: GREEN.1, U$4.P$13
GREEN_1: GREEN.2, U$4.P$14
GREEN_2: GREEN.3, U$4.P$15
GREEN_3: GREEN.4, U$4.P$16
GREEN_4: GREEN.5, U$4.P$17
GREEN_5: GREEN.6, U$4.P$18
GREEN_6: GREEN.7, U$4.P$19
GREEN_7: GREEN.8, U$4.P$20
RED_0: RED.1, U$4.P$5
RED_1: RED.2, U$4.P$6
RED_2: RED.3, U$4.P$7
RED_3: RED.4, U$4.P$8
RED_4: RED.5, U$4.P$9
RED_5: RED.6, U$4.P$10
RED_6: RED.7, U$4.P$11
RED_7: RED.8, U$4.P$12
