atsmith3/IFE_DISPLAY_2017_18/Schematics/IFE_DISPLAY/Display_Board.brd

## EAGLE design Schematics/IFE_DISPLAY/Display_Board.brd (2018-02-15, an earlier design)

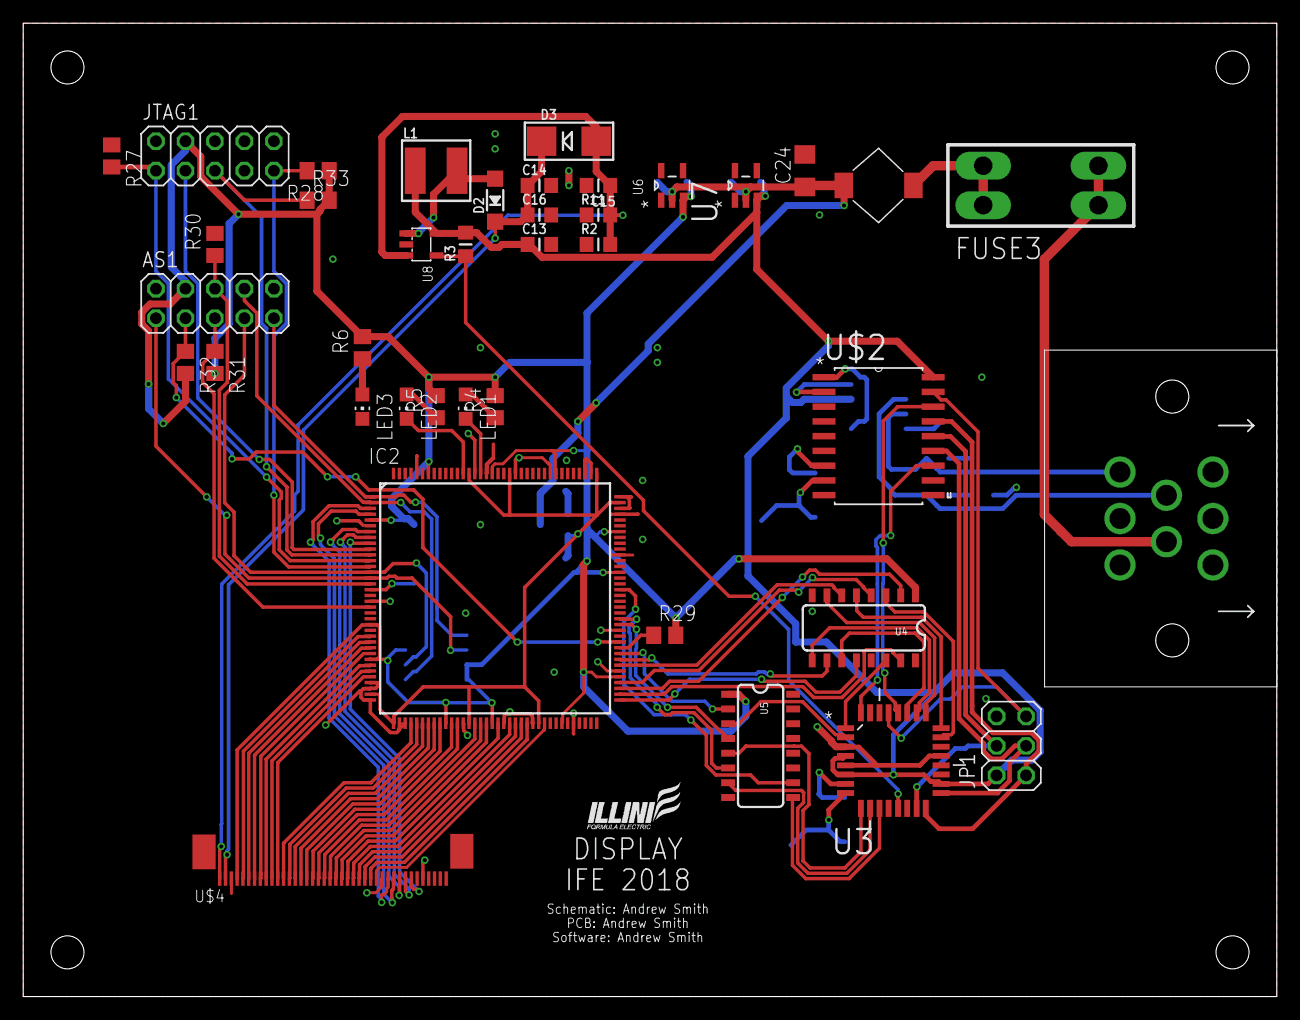
[picture p67: board Display_Board.brd from above]

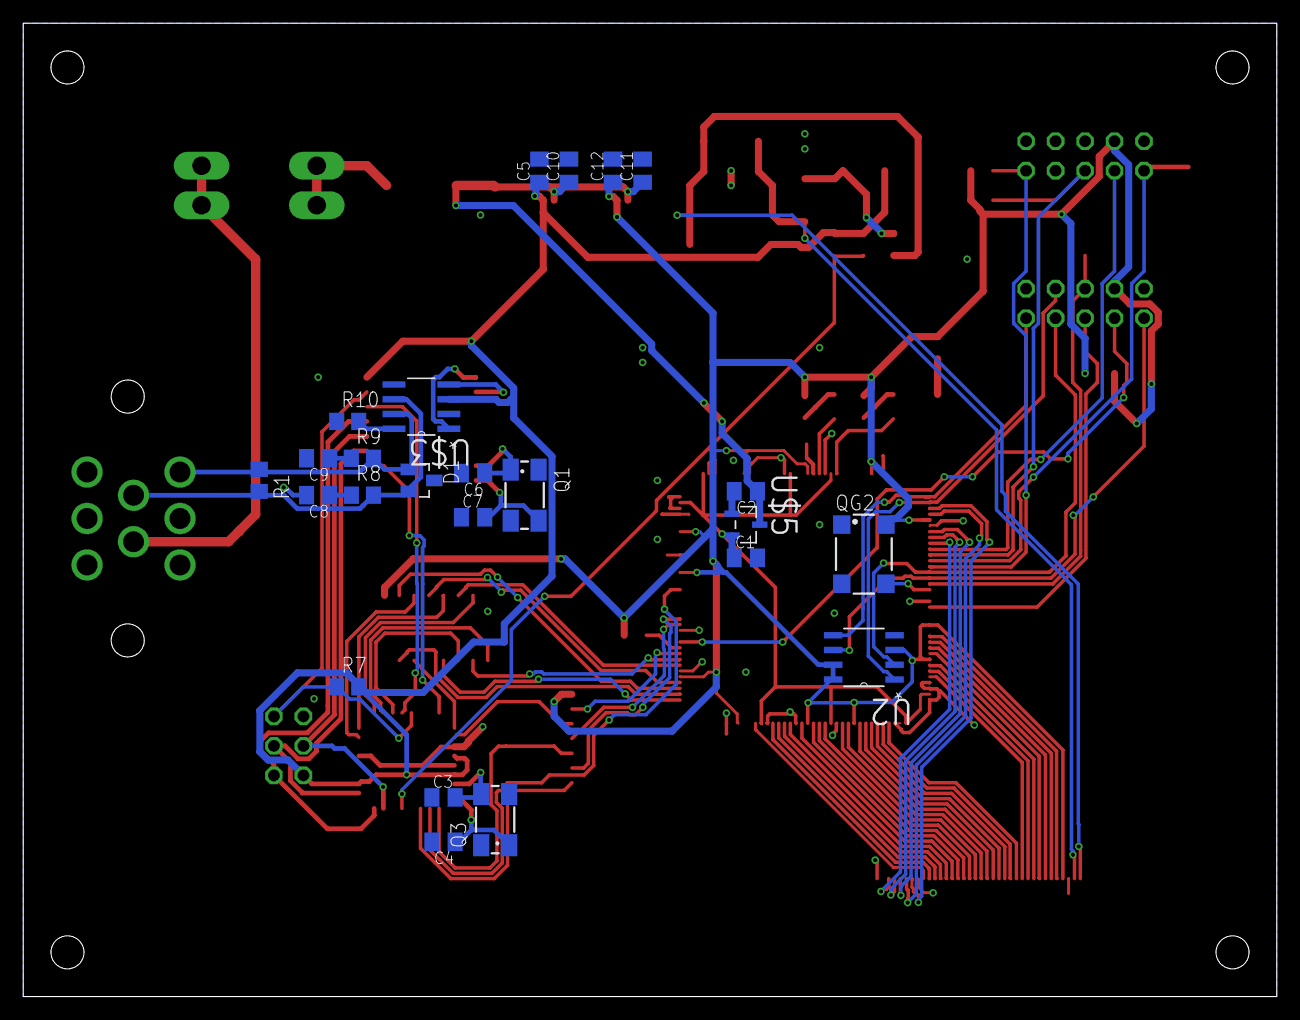
[picture p68: board Display_Board.brd from below]

Board: 2 copper layers, 108.0 x 83.8 mm, 63 parts (24 on the bottom side), 95 nets.

Parts:
AS1: 2X05
C1, C2: 1uF; C0805K
C3, C4, C6, C7: 22p; C0805K
C5, C10, C11, C12: 0.1u; C0805K
C8, C9: 560p; C0805K
C13: 10uF; _0805MP
C14, C16: 1uF; _0805MP
C15: 0.1uF; _0805MP
C24: 220u; C1206
D1: PESD1CAN; SOT23
D2: MBR0540; SOD-123
D3: MM3Z24VT1G; SMADIODE
FUSE3: MINI297-3568; 3568
IC2: EP2C5T144; TQFP144
JP1: 2X03
JTAG1: 2X05
L1: 6.8uH power L CID 2276; INDUCTOR_5X5MM_NR5040_NOTHERMALS
L5: 20uH; MSS7348
LED1, LED2, LED3: CHIP-LED0805
Q1, Q3: 16MHz; CTS406
QG2: SM77H
R1: 120; R0805
R2: 12Ω; _0805MP
R3: 10K; _0805MP
R4, R5, R6, R8, R9: 100; R0805
R7: 10k; R0805
R10: 4.7k; R0805
R11: 6Ω; _0805MP
R27, R28, R33: 1K; R0805
R29, R30, R31, R32: 10K; R0805
U2: EPCS1SI8N; SOIC127P600X175-8N
U3: QFP80P900X900X120-32N
U4, U5: HEX_CONVERTER; SO016
U6: MC78LC33NTRG; SOT95P275X110-5N
U7: MC78LC50NTRG; SOT95P275X110-5N
U8: FAN5333BSX; SOT23-5@1
U$1: 776280-1
U$2: MCP2515; SOIC127P1034X264-18N
U$3: MCP2551; SOIC127P600X175-8N
U$4: ZIF40_0.5MM_PITCH; ZIF40
U$5: MCP1702T-1202E/CB; SOT95P300X145-3N

Connections:
50_MHZ: IC2.17, QG2.3
2515_OSC1: C7.2, Q1.3, U$2.8
2515_OSC2: C6.1, Q1.1, U$2.7
+3V3: AS1.4, C12.1, IC2.5, IC2.23, IC2.29, IC2.46, IC2.54, IC2.66, IC2.77, IC2.95, IC2.102, IC2.116, IC2.127, IC2.138, JTAG1.4, QG2.4, R4.2, R5.2, R6.2, R28.1, R29.2, R31.2, R32.2, R33.2, U2.3, U2.7, U2.8, U4.1, U5.1, U6.3, U$4.P$4
+5V: C5.1, C13.1, JP1.2, L1.P$1, R3.2, R7.2, U3.4, U3.6, U3.18, U7.3, U8.5, U$2.18, U$3.3
+12V: C2.1, C10.1, C11.1, C24.1, L5.P$2, U6.2, U7.2, U$5.3
ASDO: AS1.9, IC2.1, U2.5
BLUE_0: IC2.52, U$4.P$21
BLUE_1: IC2.53, U$4.P$22
BLUE_2: IC2.55, U$4.P$23
BLUE_3: IC2.57, U$4.P$24
BLUE_4: IC2.58, U$4.P$25
BLUE_5: IC2.59, U$4.P$26
BLUE_6: IC2.60, U$4.P$27
BLUE_7: IC2.63, U$4.P$28
CANH: D1.1, R1.1, R9.2, U$1.3, U$3.7
CANL: D1.2, R1.2, R8.2, U$1.5, U$3.6
CONF_DONE: AS1.3, IC2.83, R32.1
DATA0: AS1.7, IC2.14, U2.2
DCLK: AS1.1, IC2.15, U2.6
DISP_CLK: IC2.3, U$4.P$30
DISP_DEN: IC2.9, U$4.P$34
DISP_EN: IC2.4, U$4.P$31
DISP_HSYNC: IC2.7, U$4.P$32
DISP_LEDA: C14.1, C16.1, D2.C, D3.C, U$4.P$2
DISP_LEDK: C15.1, D3.A, R2.2, R11.2, U8.3, U$4.P$1
DISP_PWM: R3.1, U3.13, U8.4
DISP_VSYNC: IC2.8, U$4.P$33
FPGA_D0_3_3: IC2.75, U4.2
FPGA_D1_3_3: IC2.76, U4.4
FPGA_D2_3_3: IC2.79, U4.6
FPGA_D3_3_3: IC2.80, U4.10
FPGA_DATA0: U3.23, U4.3
FPGA_DATA1: U3.24, U4.5
FPGA_DATA2: U3.25, U4.7
FPGA_DATA3: U3.26, U4.9
FPGA_R0_3_3: IC2.81, U5.2
FPGA_R1_3_3: IC2.86, U5.4
FPGA_R2_3_3: IC2.87, U5.6
FPGA_R3_3_3: IC2.92, U5.10
FPGA_REG0: U3.2, U5.3
FPGA_REG1: U3.9, U5.5
FPGA_REG2: U3.10, U5.7
FPGA_REG3: U3.11, U5.9
FPGA_REG_SEL: U3.27, U4.11
FPGA_RSEL_3_3: IC2.73, U4.12
FPGA_WRITE: U3.1, U4.14
FPGA_W_3_3: IC2.74, U4.15
GND: AS1.2, AS1.10, C1.2, C2.2, C3.1, C4.2, C5.2, C6.2, C7.1, C8.2, C9.2, C10.2, C11.2, C12.2, C13.2, C14.2, C15.2, C16.2, C24.2, D1.3, IC2.6, IC2.19, IC2.33, IC2.34, IC2.36, IC2.38, IC2.39, IC2.49, IC2.56, IC2.61, IC2.68, IC2.78, IC2.84, IC2.85, IC2.98, IC2.105, IC2.106, IC2.108, IC2.110, IC2.111, IC2.117, IC2.123, IC2.128, IC2.130, IC2.140, JP1.6, JTAG1.2, JTAG1.10, LED3.C, QG2.2, R2.1, R10.1, R11.1, R27.1, R30.2, U2.4, U3.3, U3.5, U3.21, U4.8, U5.8, U6.1, U7.1, U8.2, U$1.1, U$2.9, U$3.2, U$4.P$3, U$4.P$29, U$4.P$36, U$5.1
GREEN_0: IC2.41, U$4.P$13
GREEN_1: IC2.42, U$4.P$14
GREEN_2: IC2.43, U$4.P$15
GREEN_3: IC2.44, U$4.P$16
GREEN_4: IC2.45, U$4.P$17
GREEN_5: IC2.47, U$4.P$18
GREEN_6: IC2.48, U$4.P$19
GREEN_7: IC2.51, U$4.P$20
LED1: IC2.129, LED1.C
LED2: IC2.132, LED2.C
MISO: JP1.1, U3.16, U$2.15
MOSI: JP1.4, U3.15, U$2.14
unnamed: FUSE3.P$1, FUSE3.P$4, L5.P$1
unnamed: LED1.A, R4.1
unnamed: LED2.A, R5.1
unnamed: LED3.A, R6.1
unnamed: R10.2, U$3.8
unnamed: C8.1, R8.1
unnamed: C9.1, R9.1
unnamed: D2.A, L1.P$2, U8.1
unnamed: IC2.82, R29.1
NCE: AS1.6, IC2.16, R30.1
NCONFIG: AS1.5, IC2.20, R31.1
NCSO: AS1.8, IC2.2, U2.1
PWR_IN_12: FUSE3.P$2, FUSE3.P$3, U$1.4
RED_0: IC2.25, U$4.P$5
RED_1: IC2.26, U$4.P$6
RED_2: IC2.27, U$4.P$7
RED_3: IC2.28, U$4.P$8
RED_4: IC2.30, U$4.P$9
RED_5: IC2.31, U$4.P$10
RED_6: IC2.32, U$4.P$11
RED_7: IC2.40, U$4.P$12
RESET: JP1.5, R7.1, U3.29, U$2.17
RXCAN: U$2.2, U$3.4
SCK: JP1.3, U3.17, U$2.13
TCK: IC2.12, JTAG1.1, R27.2
TDI: IC2.13, JTAG1.9, R28.2
TDO: IC2.10, JTAG1.3
TMS: IC2.11, JTAG1.5, R33.1
TXCAN: U$2.1, U$3.1
VCC: C1.1, IC2.35, IC2.37, IC2.50, IC2.62, IC2.107, IC2.109, IC2.124, IC2.131, U$5.2
XTAL1: C3.2, Q3.3, U3.7
XTAL2: C4.1, Q3.1, U3.8
~CS_CAN: U3.28, U$2.16
~INT_CAN: U3.32, U$2.12
