atsmith3/IFE_DISPLAY_2017_18/Software/SYSTEM_VERILOG_DISPLAY/disp_render.sv

module disp_main
(
    input logic [9:0] DrawX, DrawY,
    output logic [1:0] color,
    output logic draw
);
reg disp_bg[272][480];

always_comb begin
    draw = 1;
    color = disp_bg[DrawY][DrawX];
end

always_ff begin
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
end

endmodule
