atsmith3/IFE_DISPLAY_2017_18/Software/SAMD21J18A_IFE_DISPLAY/SAMD21J18A_IFE_DISPLAY/display_board_defs.h

/*
 * display_board_defs.h
 *
 * Created: 6/28/2017 11:11:02 PM
 *  Author: Andrew
 */ 


#ifndef DISPLAY_BOARD_DEFS_H_
#define DISPLAY_BOARD_DEFS_H_

/* Outputs */
#define LED0				PORT_PB30

/* Inputs */
#define SW0					PORT_PA15

/* Statuses */
#define STATUS_OK			0
#define STATUS_ERR			-1


#endif /* DISPLAY_BOARD_DEFS_H_ */
