atsmith3/IFE_DISPLAY_2017_18/Software/SAMD21J18A_IFE_DISPLAY/SAMD21J18A_IFE_DISPLAY/sprites.h

/*
 * sprites.h
 *
 * Created: 6/29/2017 9:30:58 PM
 *  Author: Andrew
 */ 


#ifndef SPRITES_H_
#define SPRITES_H_

extern unsigned char speed_000;
extern unsigned char speed_005;
extern unsigned char speed_010;
extern unsigned char speed_015;
extern unsigned char speed_020;
extern unsigned char speed_025;
extern unsigned char speed_030;
extern unsigned char speed_035;
extern unsigned char speed_040;
extern unsigned char speed_045;
extern unsigned char speed_050;
extern unsigned char speed_055;
extern unsigned char speed_060;
extern unsigned char speed_065;
extern unsigned char speed_070;
extern unsigned char speed_075;
extern unsigned char speed_080;
extern unsigned char speed_085;
extern unsigned char speed_090;
extern unsigned char speed_095;
extern unsigned char speed_100;

#endif /* SPRITES_H_ */
