atsmith3/IFE_DISPLAY_2017_18/(commit log)

2017-06-30 Adding documentation
    [Display_BOM.xlsx]
2017-06-30 Design Changes
    [Display_BOM.xlsx]
2017-09-08 Finished bootloader circuitry for Cyclone II
    [Display_Board.sch]
2017-09-08 Added Micro programmer circuit
    [Display_Board.sch]
2017-09-28 Starting Layout of Motor Controller Interface
2017-09-28 Adding projects
    [data_recorder.sch, motor_controller_link.brd, motor_controller_link.sch]
2017-10-08 More work on Display Schematic
    [Display_Board.sch]
2017-10-09 Figuring out power circuit
    [Display_Board.sch, motor_controller_link.brd]
2017-10-10 More progress on the schematic
    [Display_Board.brd, Display_Board.sch, motor_controller_link.brd, motor_controller_link.sch]
2017-10-15 Started creating the ZIF 40 Pin Connector
2017-10-15 Working on Breakout Board Layout
    [Display_Board.sch, display_breakout.sch]
2017-10-15 Display Breakout Board done
    [display_breakout.brd]
2017-10-16 figuring out DC-DC converters
    [Display_Board.brd, Display_Board.sch]
2017-10-28 DCDC added need to adjust values
    [Display_Board.sch]
2017-10-31 Finalizing Display Schematic
    [Display_Board.brd, Display_Board.sch]
2017-10-31 Initial board organization. Time to route
    [Display_Board.brd, Display_Board.sch]
2017-11-02 Layout started
    [Display_Board.brd, Display_Board.sch]
2017-11-02 Routing and thinking about the FPC connector
    [Adafruit 40pin TFT friend.brd, Adafruit 40pin TFT friend.sch, Display_Board.brd]
2017-11-02 More optimizations and working on interconnect for display board
    [Display_Board.brd, Display_Board.sch]
2017-11-02 Board Complete, DRC Complete, Just have to add Name and IFE Logo
    [Display_Board.brd]
2017-11-03 Finished display board, added IFE BMP and text
    [Display_Board.brd]
2017-11-03 Fixed some random clearance issues
    [Display_Board.brd]
2017-11-05 Finished design v1.0
    [Display_Board.brd]
2017-11-07 Display Driver Working
    [IFE_Display_2017.smp_dump.txt, verilog.psm]
2017-11-10 added 120 ohm resistor
    [Display_Board.brd, Display_Board.sch]
2017-12-02 Redid the Switching Supplies
    [Display_Board.brd, Display_Board.sch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]
2017-12-11 Added 3d model of board
    [display.skp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]
2017-12-11 Added BOM
    [Display_Board.csv, bom.xlsx]
2017-12-12 Restructuring Memory
    [IFE_Display_2017.smp_dump.txt]
2017-12-18 Switching to PC
2017-12-18 Finishing up hardware portion of report
    [Display_Board.sch]
2018-01-17 Resized Vias
    [Display_Board.brd]
2018-02-13 Changes to Serial Config Device
2018-02-15 Adding cyclone 10 devices for version2
    [Display_Board.brd, Display_Board_v2.sch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]
2018-02-15 adding linear regs
    [Display_Board_v2.sch]
2018-02-15 Created Linear Regulators
2018-02-16 Working on adding 2.5V for the PLL
    [Display_Board_v2.sch]
2018-02-16 Creating 2.5V reg
2018-02-16 New 2.5V reg
2018-02-16 Finished power dist - Working on optimizing connections to FPGA
    [Display_Board_v2.sch]
2018-02-17 General Layout
    [Display_Board_v2.brd, Display_Board_v2.sch]
2018-02-17 Need to fix oscillators, Initial placement done
    [Display_Board_v2.brd, Display_Board_v2.sch]
2018-02-17 Updted Oscillators, routing ~60%
    [Display_Board_v2.brd, Display_Board_v2.sch]
2018-02-17 Finished Routing, Adding LOGO
    [Display_Board_v2.brd]
2018-02-19 Cleaning up the aesthetic
    [Display_Board_v2.brd]
2018-02-19 Fixing Aesthetic ~ 50% COmplete
    [Display_Board_v2.brd]
2018-02-20 Getting board size down on X axis so it is cheaper
    [Display_Board_v2.brd]
2018-02-20 Fixed board sizeing for cost efficiency + Aesthetic
    [Display_Board_v2.brd]
2018-02-21 Added gerbers
    [Display_Board_v2.brd, Display_Board_v2.sch]
2018-02-23 Made LED Driver Test Circuit
    [led_boost_test.brd, led_boost_test.sch]
2018-02-25 Added New Relay
2018-03-27 Made a few custom parts
    [Display_Board_v2.brd, Display_Board_v2.sch, led_boost_test.brd]
2018-04-11 Added new devices
2018-04-16 Added Parts
    [Display_Board_v2.sch]
2018-04-16 Testing Cyclone 10 programming
    [Display_Board_v2.csv]
2018-04-19 Working on R3
    [Display_Board_v3.brd, Display_Board_v3.sch]
2018-04-19 V3 Under Review
    [Display_Board_v3.brd, Display_Board_v3.sch]
2018-04-19 Reviewed and Ordered V3
    [Display_Board_v3.brd]
2018-04-29 Generating track for packman
2018-04-29 added track
2018-06-05 Display v4 - What should have been done all along
    [Display_Board_v3.brd, Display_Board_v4.brd, Display_Board_v4.sch]
2018-06-06 Display v4 - Routing
    [Display_Board_v4.brd, Display_Board_v4.sch]
2018-06-06 Display v4 - ready to autoroute
    [Display_Board_v4.brd]
2018-06-06 Display v4 - autorouted
    [Display_Board_v4.brd, Display_Board_v4.sch]
2018-06-06 Display v4 - Adding FTDI for ease of programming
    [Display_Board_v4.brd, Display_Board_v4.sch]
2018-06-07 v4 Ready to be printed
    [Display_Board_v4.brd, Display_Board_v4.sch]
2018-07-30 Added 2 new power relays
    [Display_Board_v4.brd, Display_Board_v4.sch]
2018-07-31 Added SPST Relay
